immersive-arts/Blimpy/apps/readme.md

# apps

## blender-path

shows how to use blender to create a flightpath and then sending the position and orientation via OSC to a MaxMSP patch to drive a blimp.

Requires the 'blimpy4max' packages to be linked to the packages folder.

## flock_simulation

This Max msp patch is a flocking simulation to auto-control the helium blimps. The simulation sends a position and velocity vector to the manager.

This patch uses an older API and is currently not in working condition.

## ios-remote

iOS app for remote controlling blimps via iPhone or iPad.

## tools

max patches to help.

##XboX-remote

max patch to remote control blimps via xbox - remote controller.
