immersive-arts/Blimpy/robots/wheely/readme.md

# Wheely: Design and Assembly

## 1. Overview
The wheely robot is a ground robot employing mecanum wheels for instantenous movement in any direction.

### Mk02
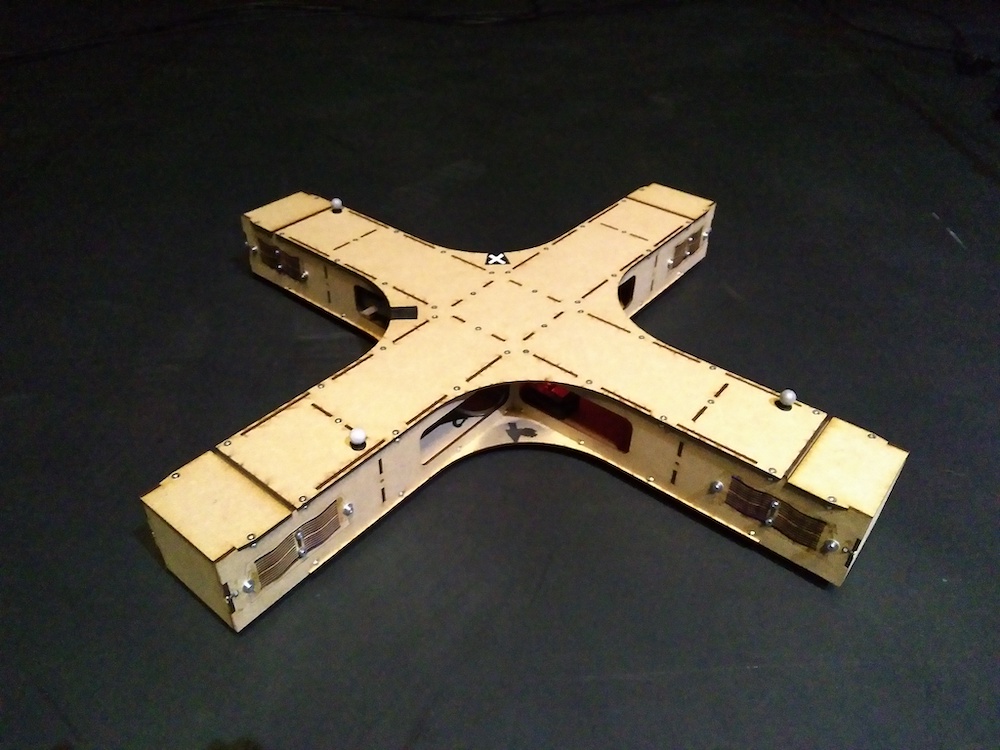
[picture p6: assets/pix/robots/wheely/wheely_mk02.jpg]
 [link](./design/mechanics/mk02/readme.md)

### Mk03
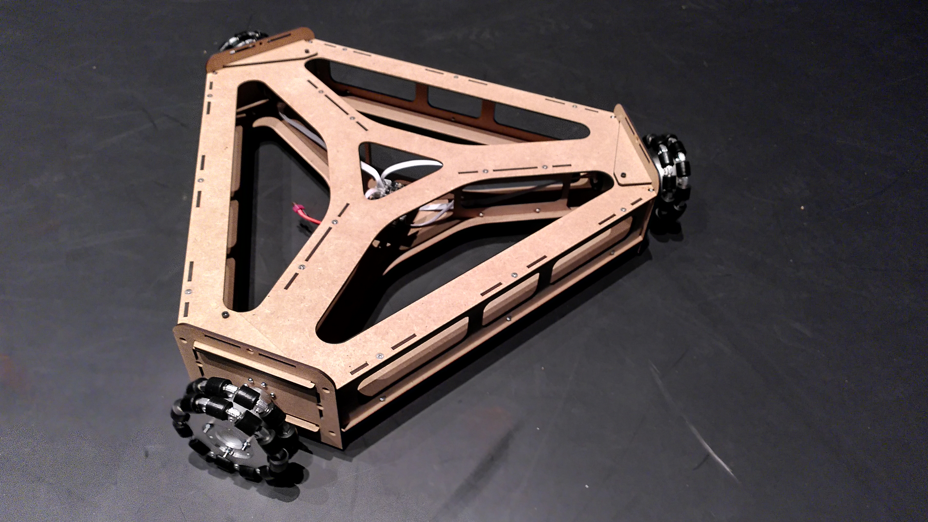
[picture p7: assets/pix/robots/wheely/wheely_mk03.jpg]
 [link](./design/mechanics/mk03.4/readme.md)
