immersive-arts/Blimpy/apps/ios-remote/readme.md

# iOS Remote

The app is able to control one Blimp. The flight model must be functional for this to work properly.

## Usage

Use the two joysticks to steer the blimp. Enable motion sensors for more advanced controls.

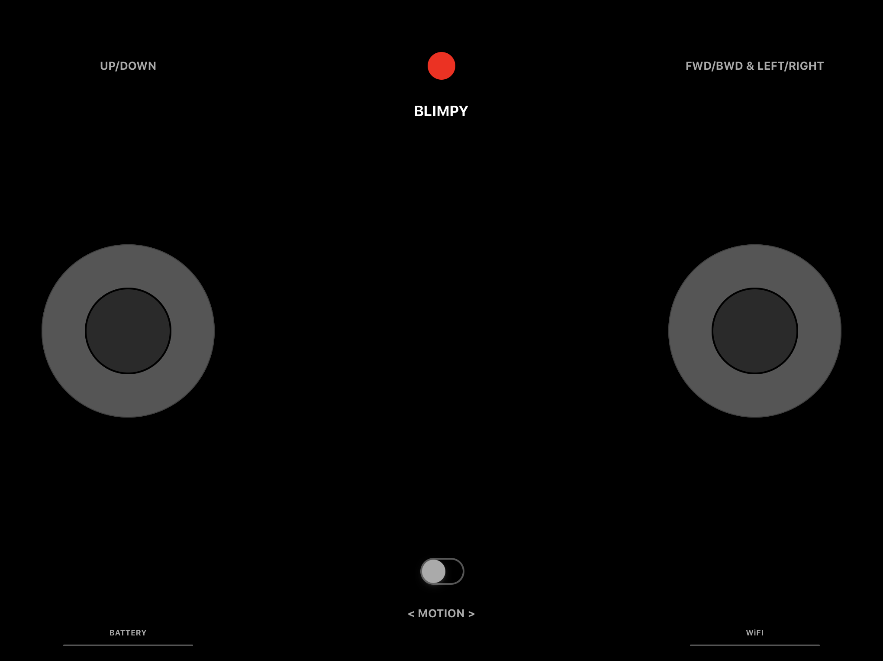
[picture p31: assets/pix/apps/ios-remote/ui.png]


### Configuration

The app can be configured using the "Settings" app on the iPad.

The settings should match the ones used to configure the controller for the blimp that should be controlled with the remote.

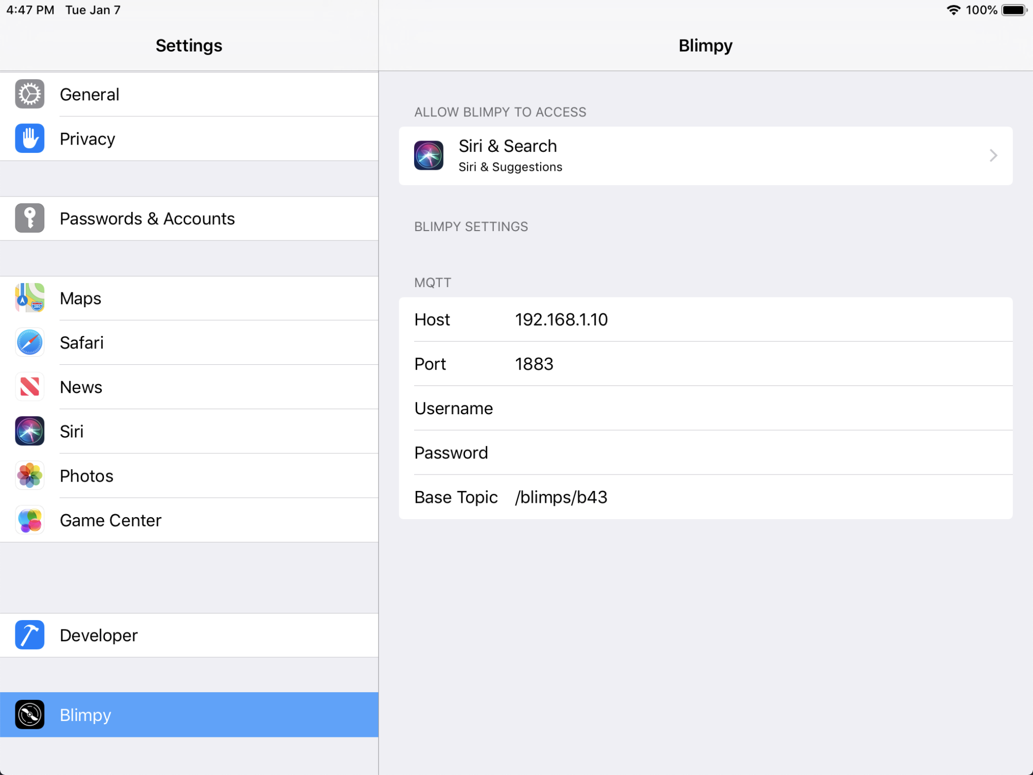
[picture p32: assets/pix/apps/ios-remote/settings.png]


## Installation

To compile and run the app to an iPad you need "Xcode" on your Mac. Before building and running, make sure to set up the project with your own provisioning profile.

### Dependencies

Dependencies are manages using ["CocoaPods"](https://cocoapods.org/app). Download the app and load the project in order to get the dependencies.
