immersive-arts/Blimpy/assets/pix/motorAttachements.pdf

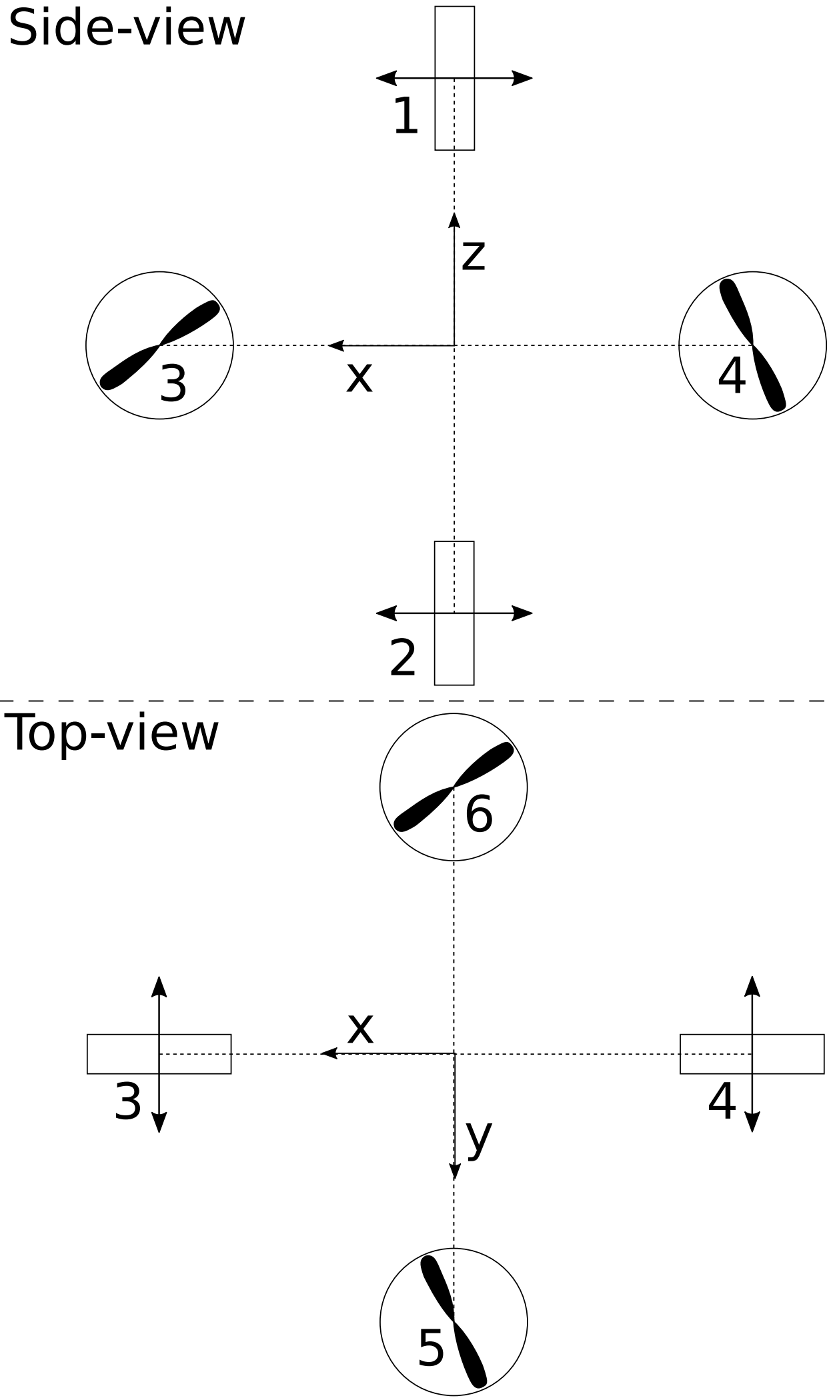
[picture p33: figure]
Side-view; Top-view
