immersive-arts/Blimpy/apps/processing/blimpybirdy/data/bg.jpg

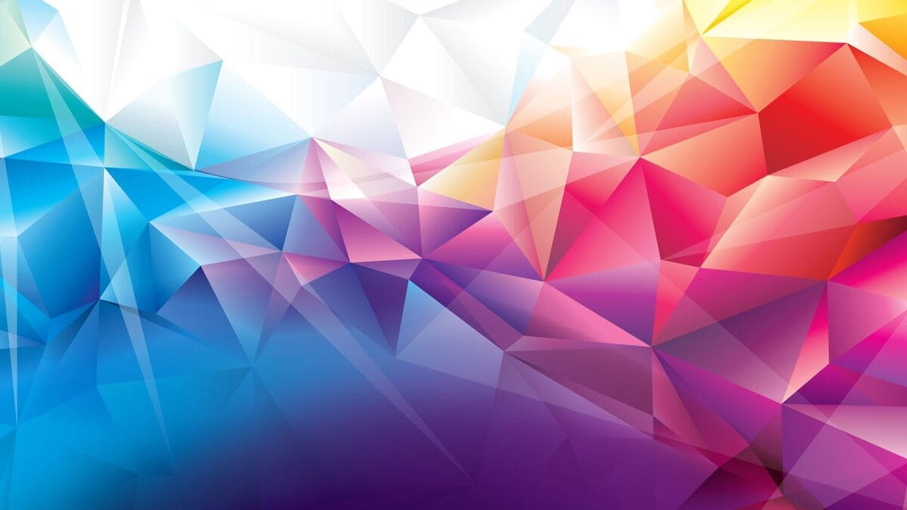
apps/processing/blimpybirdy/data/bg.jpg
