immersive-arts/Blimpy/assets/pix/apps/max/openQueScriptProperties.jpg

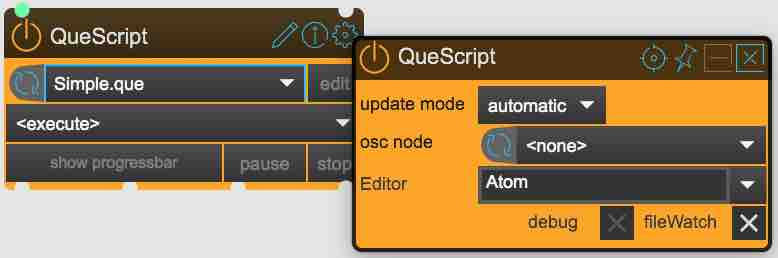
assets/pix/apps/max/openQueScriptProperties.jpg
