immersive-arts/Blimpy/assets/pix/apps/max/QueScript.jpg

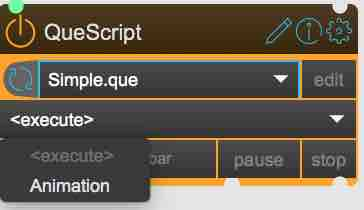
assets/pix/apps/max/QueScript.jpg
