immersive-arts/Blimpy/assets/pix/controller.jpg

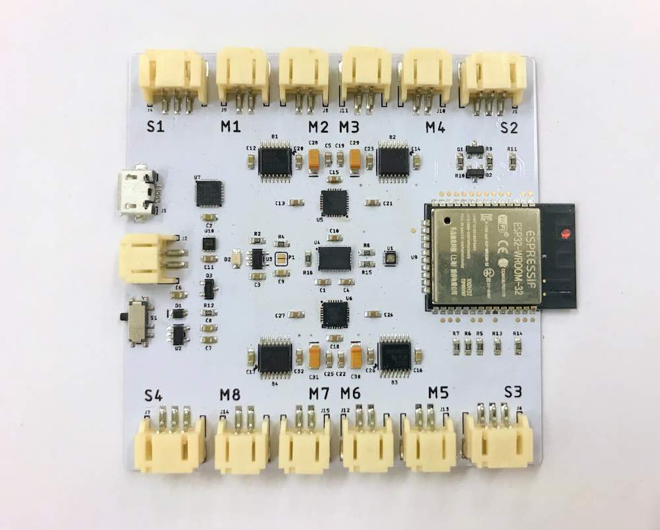
assets/pix/controller.jpg
