immersive-arts/Blimpy/assets/pix/firmware/BT_deviceConfig_Device.jpg

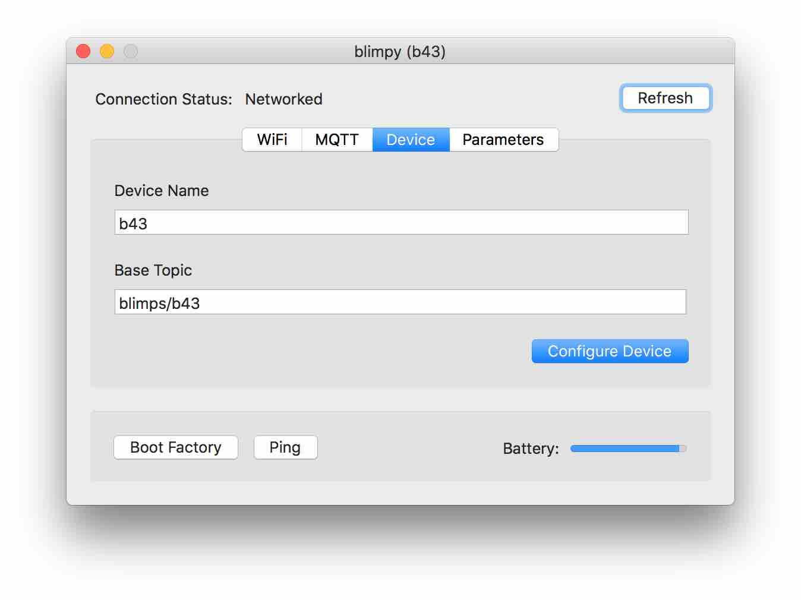
assets/pix/firmware/BT_deviceConfig_Device.jpg
