immersive-arts/Blimpy/assets/pix/firmware/BT_deviceConfig_MQTT.jpg

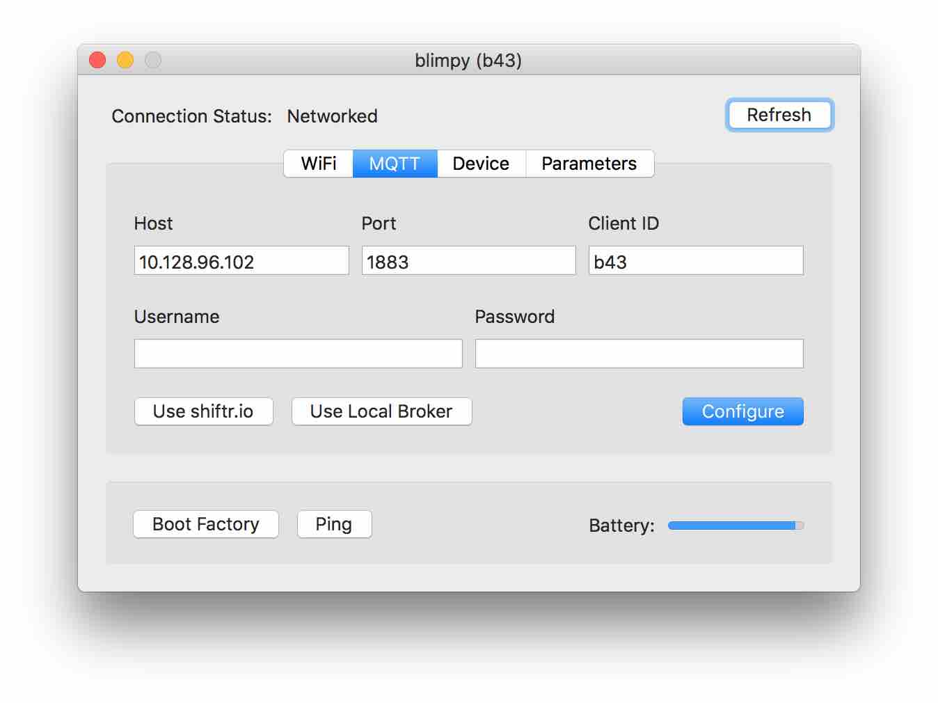
assets/pix/firmware/BT_deviceConfig_MQTT.jpg
