immersive-arts/Blimpy/assets/pix/firmware/BT_deviceConfig_Wifi.jpg

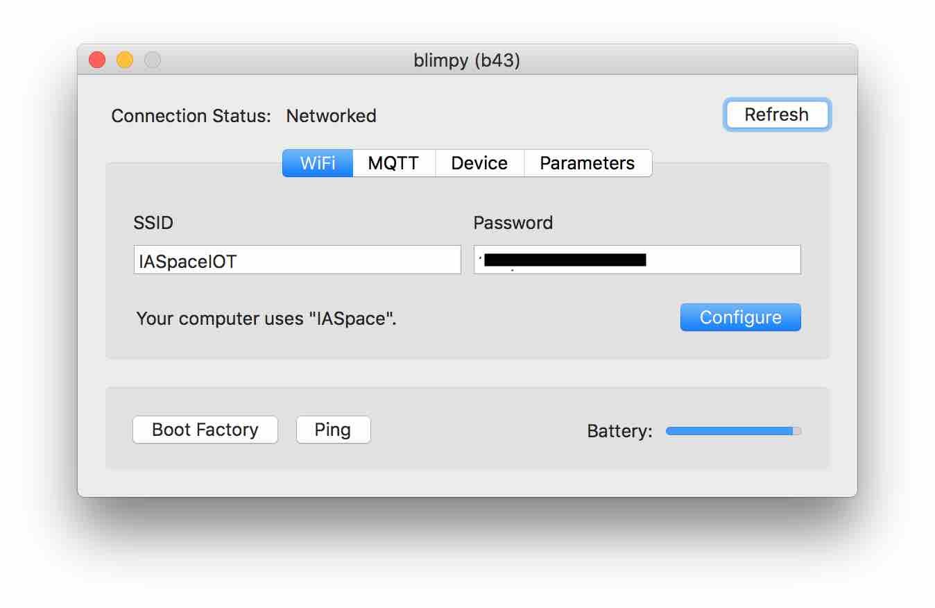
assets/pix/firmware/BT_deviceConfig_Wifi.jpg
