immersive-arts/Blimpy/assets/pix/Motors.jpg

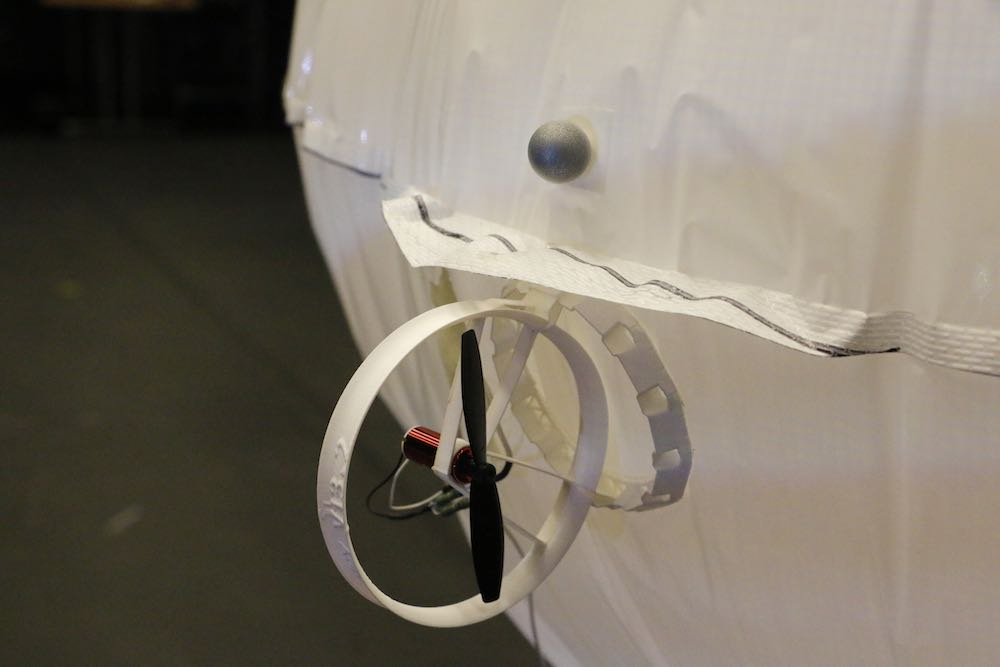
assets/pix/Motors.jpg
