immersive-arts/Blimpy/robots/blimpy/tetra_config.PNG

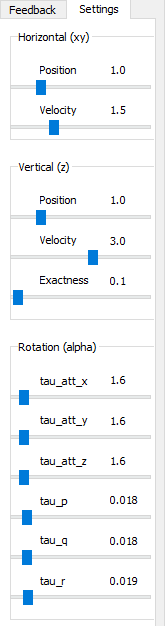
robots/blimpy/tetra_config.PNG
