immersive-arts/Blimpy/robots/blimpy/design/electronics/pcb/PCBWay/PCBWay_BOM.xlsx

Item # | *Designator | *Qty |  | Manufacturer | *Mfg Part # | Description / Value | *Package/Footprint | Type | Your Instructions / Notes | Digikey | Price per Unit | Price Total
1 | J3, J4, J5, J6, J7, J8 | 6 | 60 | JST Sales America Inc. | S2B-PH-SM4-TB | CONN HEADER SMD R/A 2POS 2MM |  | SMD |  | 455-1749-1-ND | 0.56 | 3.36
2 | U3 | 1 | 10 | Microchip | MCP73831T-2ATI/OT | IC CONTROLLR LI-ION 4.2V SOT23-5 | SOT-23-5 | SMD |  | MCP73831T-2ATI/OTCT-ND | 0.54 | 0.54
3 | R3 | 1 | 10 | Ohmite | LVT12R0050FER | RES 0.005 OHM 1% 1W 1206 | 1206 | SMD | Equivalent component permitted | LVT12R0050FERCT-ND | 0.49 | 0.49
4 | R8, R15, R19, R20, R22, R23, R25, R26, R28, R29, R31, R32 | 12 | 120 | Ohmite | KDV12DR100ET | RES 100M OHM 0.5% 1/2W 1206 | 1206 | SMD | Equivalent component permitted | 273-KDV12DR100ETCT-ND | 0.39 | 4.68
5 | C5, C11, C12, C13, C15, C16, C18, C20, C21, C22, C24, C26, C29, C31, C33, C35 | 16 | 160 | Yageo | CC0603KRX7R8BB104 | CAP CER 0.1UF 25V X7R 0603 | 0603 | SMD | Equivalent component permitted | 311-1341-1-ND | 0.1 | 1.6
6 | C7 | 1 | 10 | Yageo | CC0603KRX7R7BB105 | CAP CER 1UF 16V X7R 0603 | 0603 | SMD | Equivalent component permitted | 311-1446-1-ND | 0.11 | 0.11
7 | R1 | 1 | 10 | Yageo | RC0603FR-0710RL | RES SMD 10 OHM 1% 1/10W 0603 | 0603 | SMD | Equivalent component permitted | 311-10.0HRCT-ND | 0.41 | 0.41
8 | R12 | 1 | 10 | Yageo | RC0603FR-07100KL | RES SMD 100K OHM 1% 1/10W 0603 | 0603 | SMD | Equivalent component permitted | 311-100KHRCT-ND | 0.1 | 0.1
9 | R9, R10, R11 | 3 | 30 | Yageo | RC0603FR-0710KL | RES SMD 10K OHM 1% 1/10W 0603 | 0603 | SMD | Equivalent component permitted | 311-10.0KHRCT-ND | 0.1 | 0.3
10 | C2, C3, C6, C8, C9 | 5 | 50 | Murata | GRM188R61A106KE69J | CAP CER 10UF 10V X5R 0603 | 0603 | SMD | Equivalent component permitted | 490-14372-1-ND | 0.17 | 0.85
11 | C14, C19, C25, C28, C30, C34 | 6 | 60 | KEMET | T491A106K010AT | CAP TANT 10UF 10% 10V 1206 | 1206 | SMD | Equivalent component permitted | 399-3684-1-ND | 0.41 | 2.46
12 | D1 | 1 | 10 | STMicroelectronics | BAT20JFILM | DIODE SCHOTTKY 23V 1A SOD323 | SOD-323 | SMD |  | 497-3381-1-ND | 0.31 | 0.31
13 | R17 | 1 | 10 | Yageo | RC0603FR-071ML | RES SMD 1M OHM 1% 1/10W 0603 | 0603 | SMD | Equivalent component permitted | 311-1.00MHRCT-ND | 0.1 | 0.1
14 | R2, R5, R6, R7, R35, R36, R37 | 7 | 70 | Yageo | RC0603JR-071KL | RES SMD 1K OHM 5% 1/10W 0603 | 0603 | SMD | Equivalent component permitted | 311-1.0KGRCT-ND | 0.1 | 0.7
15 | R4 | 1 | 10 | Yageo | RC0603FR-072KL | RES SMD 2K OHM 1% 1/10W 0603 | 0603 | SMD | Equivalent component permitted | 311-2.00KHRCT-ND | 0.1 | 0.1
16 | C4, C10, C17, C23, C27, C32, C36 | 7 | 70 | Murata | GRM188R61E225KA12D | CAP CER 2.2UF 25V X5R 0603 | 0603 | SMD | Equivalent component permitted | 490-10731-1-ND | 0.18 | 1.26
17 | J9, J10, J11, J12, J13, J14, J15 | 7 | 70 | JST Sales America Inc. | S3B-PH-SM4-TB | CONN HEADER SMD R/A 3POS 2MM |  | SMD |  | 455-1750-1-ND | 0.67 | 4.69
18 | D4, D5, D6 | 3 | 30 | Osram | LG R971-KN-1 | LED GREEN DIFFUSED 0805 SMD | 0805 | SMD |  | 475-1410-1-ND | 0.25 | 0.75
19 | R13, R14, R18, R38 | 4 | 40 | Yageo | RC0603JR-074K7L | RES SMD 4.7K OHM 5% 1/10W 0603 | 0603 | SMD | Equivalent component permitted | 311-4.7KGRCT-ND | 0.1 | 0.4
20 | C1 | 1 | 10 | Yageo | CC0603KRX7R7BB474 | CAP CER 0.47UF 16V X7R 0603 | 0603 | SMD | Equivalent component permitted | 311-1428-1-ND | 0.2 | 0.2
21 | R16, R21, R24, R27, R30, R33 | 6 | 60 | Yageo | RC0603FR-0747KL | RES SMD 47K OHM 1% 1/10W 0603 | 0603 | SMD | Equivalent component permitted | 311-47.0KHRCT-ND | 0.1 | 0.6
22 | Q4 | 1 | 10 | Vishay Siliconix | SQ4431EY-T1_GE3 | MOSFET P-CH 30V 10.8A 8SOIC | 8-SOIC | SMD |  | SQ4431EY-T1_GE3CT-ND | 0.86 | 0.86
23 | Q1, Q2, Q5 | 3 | 30 | Diodes Incorporated | MMBT2222A-7-F | TRANS NPN 40V 0.6A SMD SOT23-3 | SOT-23-3 | SMD |  | MMBT2222A-FDICT-ND | 0.13 | 0.39
24 | U2 | 1 | 10 | Diodes Incorporated | AP2112K-3.3TRG1 | LDO Voltage Regulators 600mA CMOS LDO 50mA 3.3V 250mV | SOT-25-5 | SMD |  | AP2112K-3.3TRG1DICT-ND | 0.45 | 0.45
25 | D3 | 1 | 10 | Diodes Incorporated | BAS70-05WFILM | DIODE ARRAY SCHOTTKY 70V SOT323 | SOT-323 | SMD |  | 497-15794-1-ND | 0.42 | 0.42
26 | R34 | 1 | 10 | Eaton | CB61F10A-TR1 | FUSE BRD MNT 10A 125VAC/VDC SMD |  | SMD |  | 283-4102-1-ND | 1.12 | 1.12
27 | U7 | 1 | 10 | Silicon Labs | CP2104-F03-GMR | IC SGL USB-TO-UART BRIDGE 24QFN |  | SMD |  | 336-4146-1-ND | 1.6 | 1.6
28 | Q3 | 1 | 10 | Diodes Incorporated | DMP2035U-7 | MOSFET P-CH 20V 3.6A SOT-23 |  | SMD |  | DMP2035U-7DICT-ND | 0.4 | 0.4
29 | M0, M1, M2, M3, M4, M5 | 6 | 60 | Texas Instruments | DRV8833PWPR | IC MOTOR DRIVER PAR 16HTSSOP | 16-HTSSOP | SMD |  | 296-29434-1-ND | 2.01 | 12.06
30 | U9 | 1 | 10 | Espressif Systems | ESP32-WROOM-32 | RX TXRX MOD WIFI SURFACE MOUNT |  | SMD |  | 1904-1010-1-ND | 3.69 | 3.69
31 | S1 | 1 | 10 | Panasonic | EVQ-PUJ02K | SWITCH TACTILE SPST-NO 0.05A 12V |  | SMD |  | P10851SCT-ND | 0.57 | 0.57
32 | U4 | 1 | 10 | Maxim Integrated | MAX17201G+ | IC BATTERY MONITOR 14TDFN | 14-WFDFN Exposed Pad | SMD |  | MAX17201G+-ND | 3.29 | 3.29
33 | J1 | 1 | 10 | Hirose | ZX62-B-5PA(33) | CONN RCPT USB2.0 MICRO B SMD R/A |  | SMD |  | H125270CT-ND | 0.81 | 0.81
34 | D2 | 1 | 10 | Osram | LO R976-PS-1 | LED ORANGE DIFFUSED 0805 SMD | 0805 | SMD |  | 475-2488-1-ND | 0.27 | 0.27
35 | U1 | 1 | 10 | Cree | CLMVC-FKA-CL1D1L71BB7C3C3 | LED RGB CLEAR 4PLCC SMD | 4-PLCC | SMD |  | CLMVC-FKA-CL1D1L71BB7C3C3CT-ND | 0.18 | 0.18
36 | U5 | 1 | 10 | Semtech Corporation | SX1509BIULTRT | IC GPIO EXPANDER I2C 16CH 28QFN |  | SMD |  | SX1509BIULCT-ND | 3.44 | 3.44
 |  |  |  |  |  |  |  |  |  |  | 24.73 | 53.56
 |  | 113
