immersive-arts/Blimpy/(list of files, cad)

Other CAD files:
apps/blender-path/Show.blend
apps/blender-path/Simple.blend
assets/pix/robots/blimpy/fanSetup.blend
robots/blimpy/design/inflationSim.blend
robots/wheely/design/mechanics/mk02/wheely_mk2.blend
robots/wheely/design/mechanics/mk03.4/wheely_mk3.4.blend
