immersive-arts/Blimpy/robots/wheely/firmware/nuttx/nuttx/Documentation/guides/tasktrace.rst

==========
Task Trace
==========

Task Trace is the tool to collect the various events in the NuttX kernel and display the result graphically.

It can collect the following events.

  - Task execution, termination, switching
  - System call enter/leave
  - Interrupt handler enter/leave

.. toctree::
  :maxdepth: 1
  :caption: Contents:

  tasktraceuser.rst
  tasktraceinternal.rst

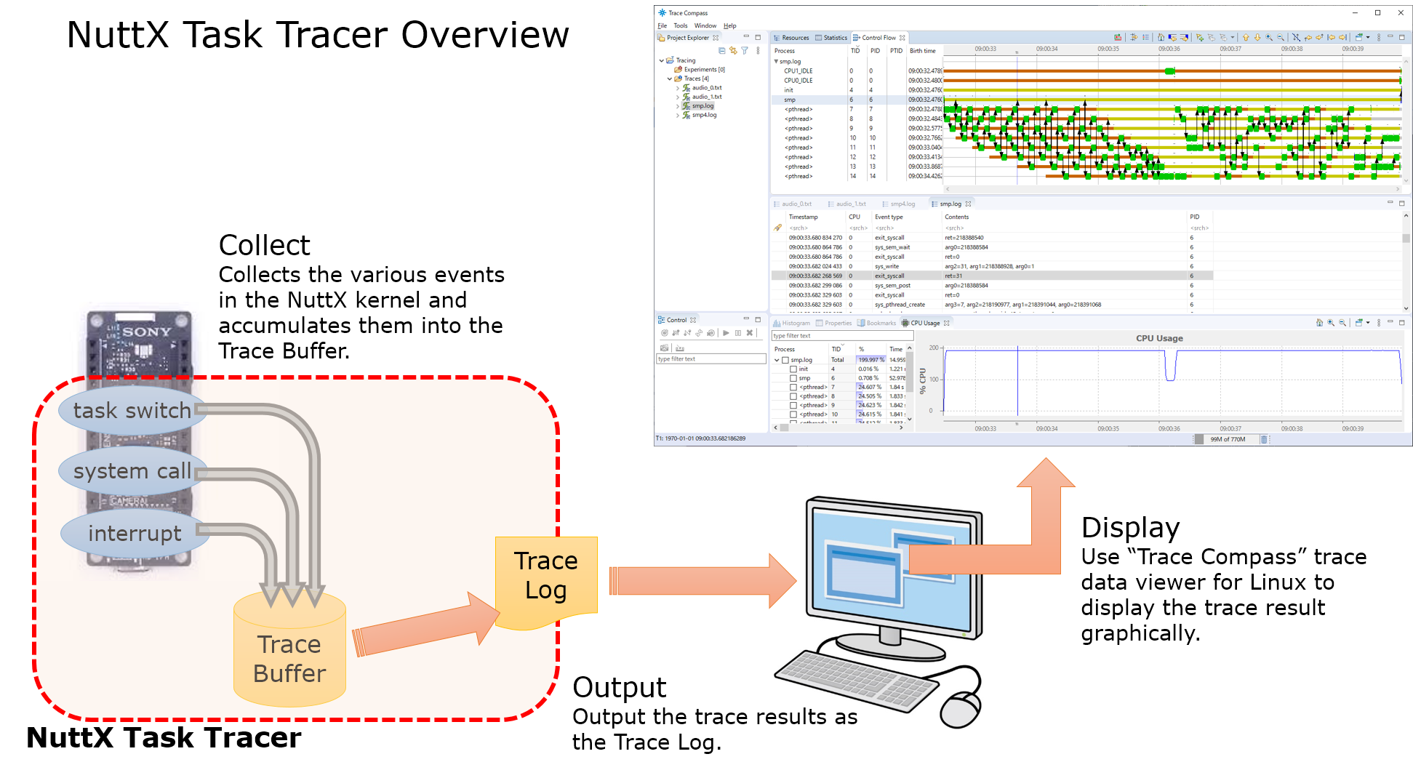
[picture p88: robots/wheely/firmware/nuttx/nuttx/Documentation/guides/image/task-trace-overview.png]
