immersive-arts/Blimpy/robots/blimpy/design/electronics/pcb/blimpy-2.1_fix.pdf

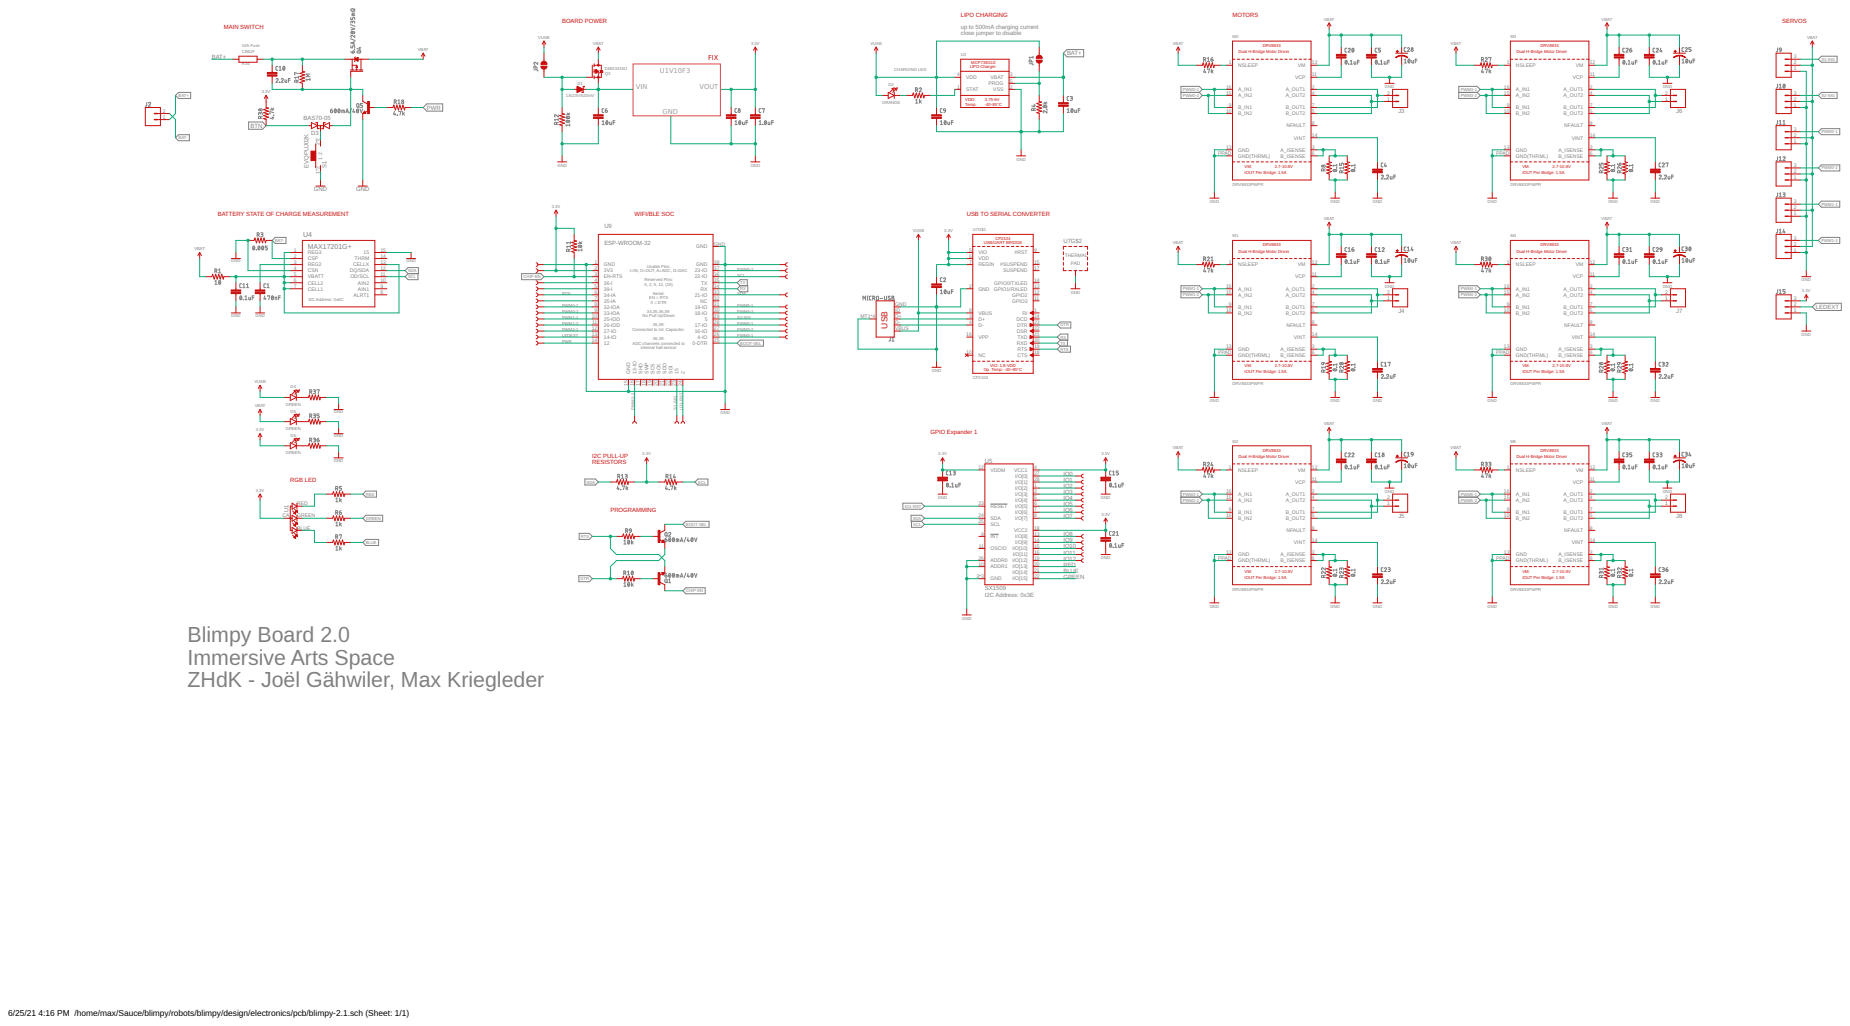
[picture p110: page 1]

LIPO CHARGING
up to 500mA charging current
close jumper to disable

Dual H-Bridge Motor Driver

BATTERY STATE OF CHARGE MEASUREMENT

USB TO SERIAL CONVERTER

I=IN, O=OUT, A=ADC, D=DAC

No Pull Up/Down

Connected to Int. Capacitor.

ADC channels connected to
internal hall sensor

Blimpy Board 2.0
Immersive Arts Space
ZHdK - Joël Gähwiler, Max Kriegleder

6/25/21 4:16 PM /home/max/Sauce/blimpy/robots/blimpy/design/electronics/pcb/blimpy-2.1.sch (Sheet: 1/1)
