immersive-arts/Blimpy/robots/blimpy/design/electronics/pcb/blimpy-2.1.pdf

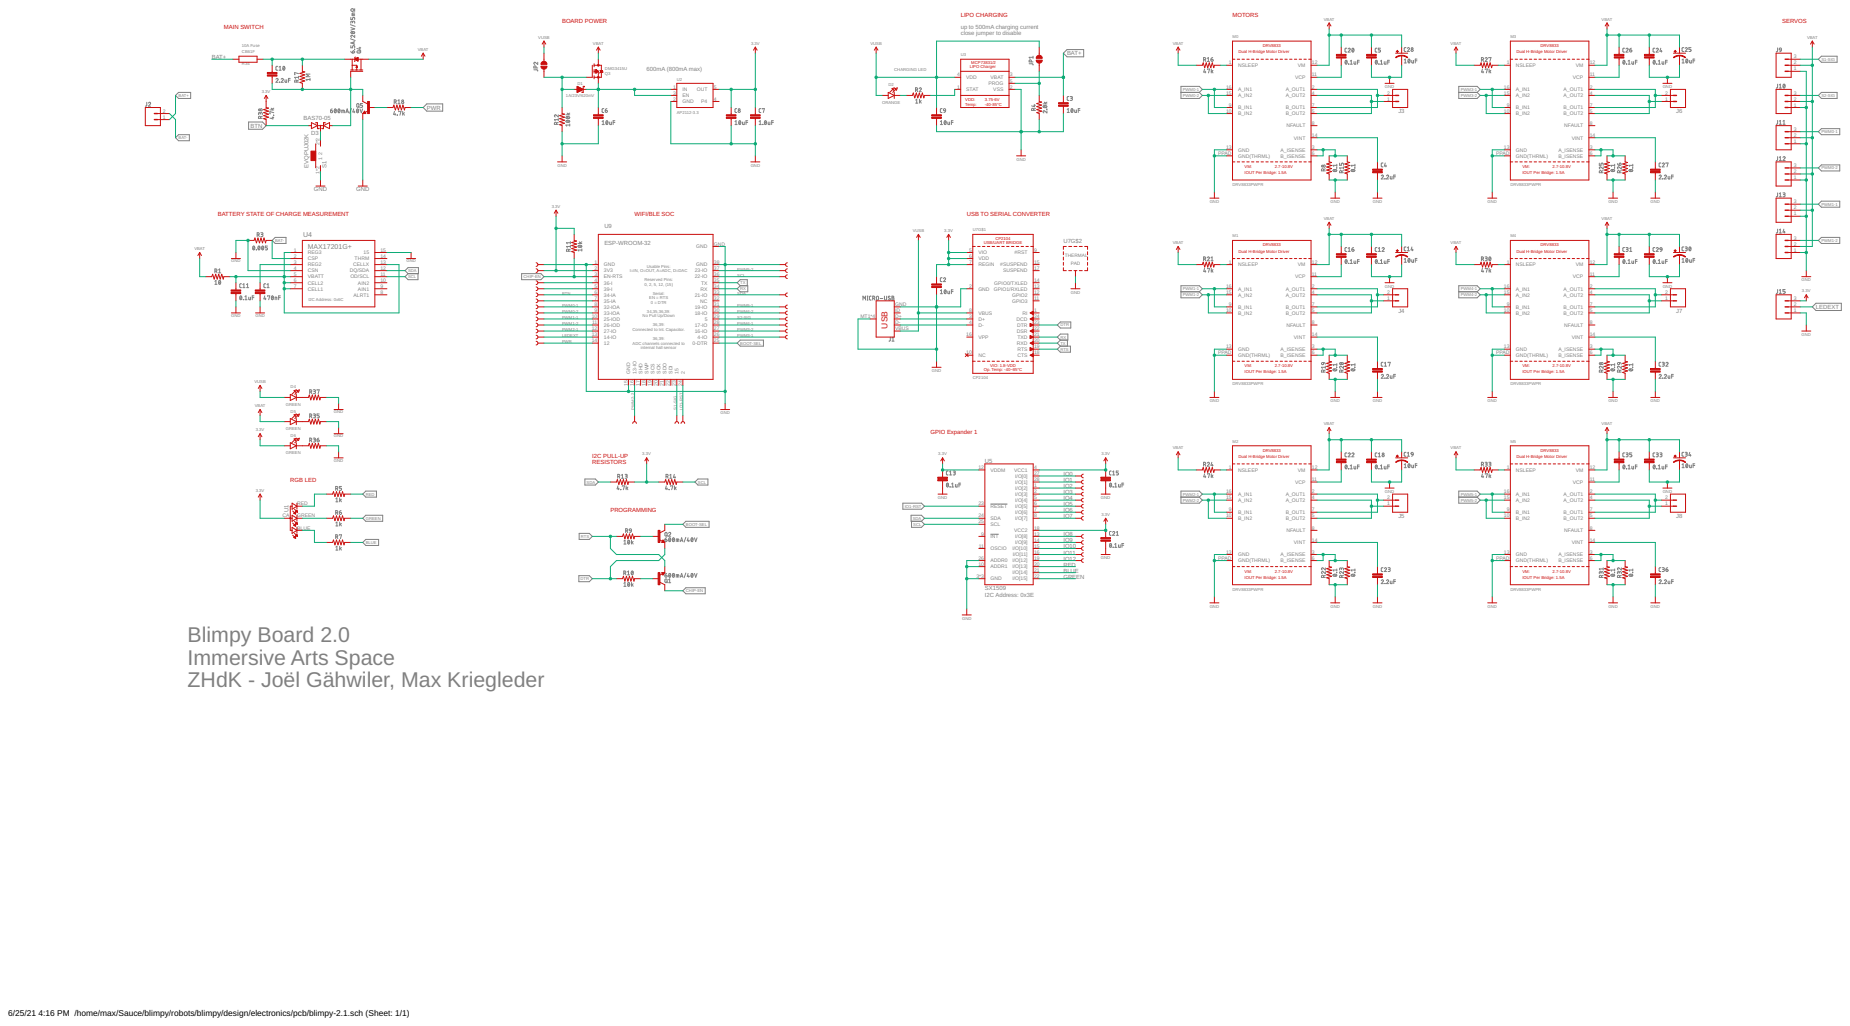
[picture p111: page 1]

LIPO CHARGING
up to 500mA charging current close jumper to disable

DRV8833 Dual H-Bridge Motor Driver

BATTERY STATE OF CHARGE MEASUREMENT

USB TO SERIAL CONVERTER

I=IN, O=OUT, A=ADC, D=DAC

Reserved Pins: 0, 2, 5, 12, (15) Serial: EN = RTS

34,35,36,39: No Pull Up/Down

VIO: 1.8-VDD Op. Temp: -40~85°C U

36,39: Connected to Int. Capacitor. 36,39: ADC channels connected to

Blimpy Board 2.0
Immersive Arts Space
ZHdK - Joël Gähwiler, Max Kriegleder

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
