immersive-arts/Blimpy/robots/blimpy/design/electronics/pcb/blimpy-2.0.pdf

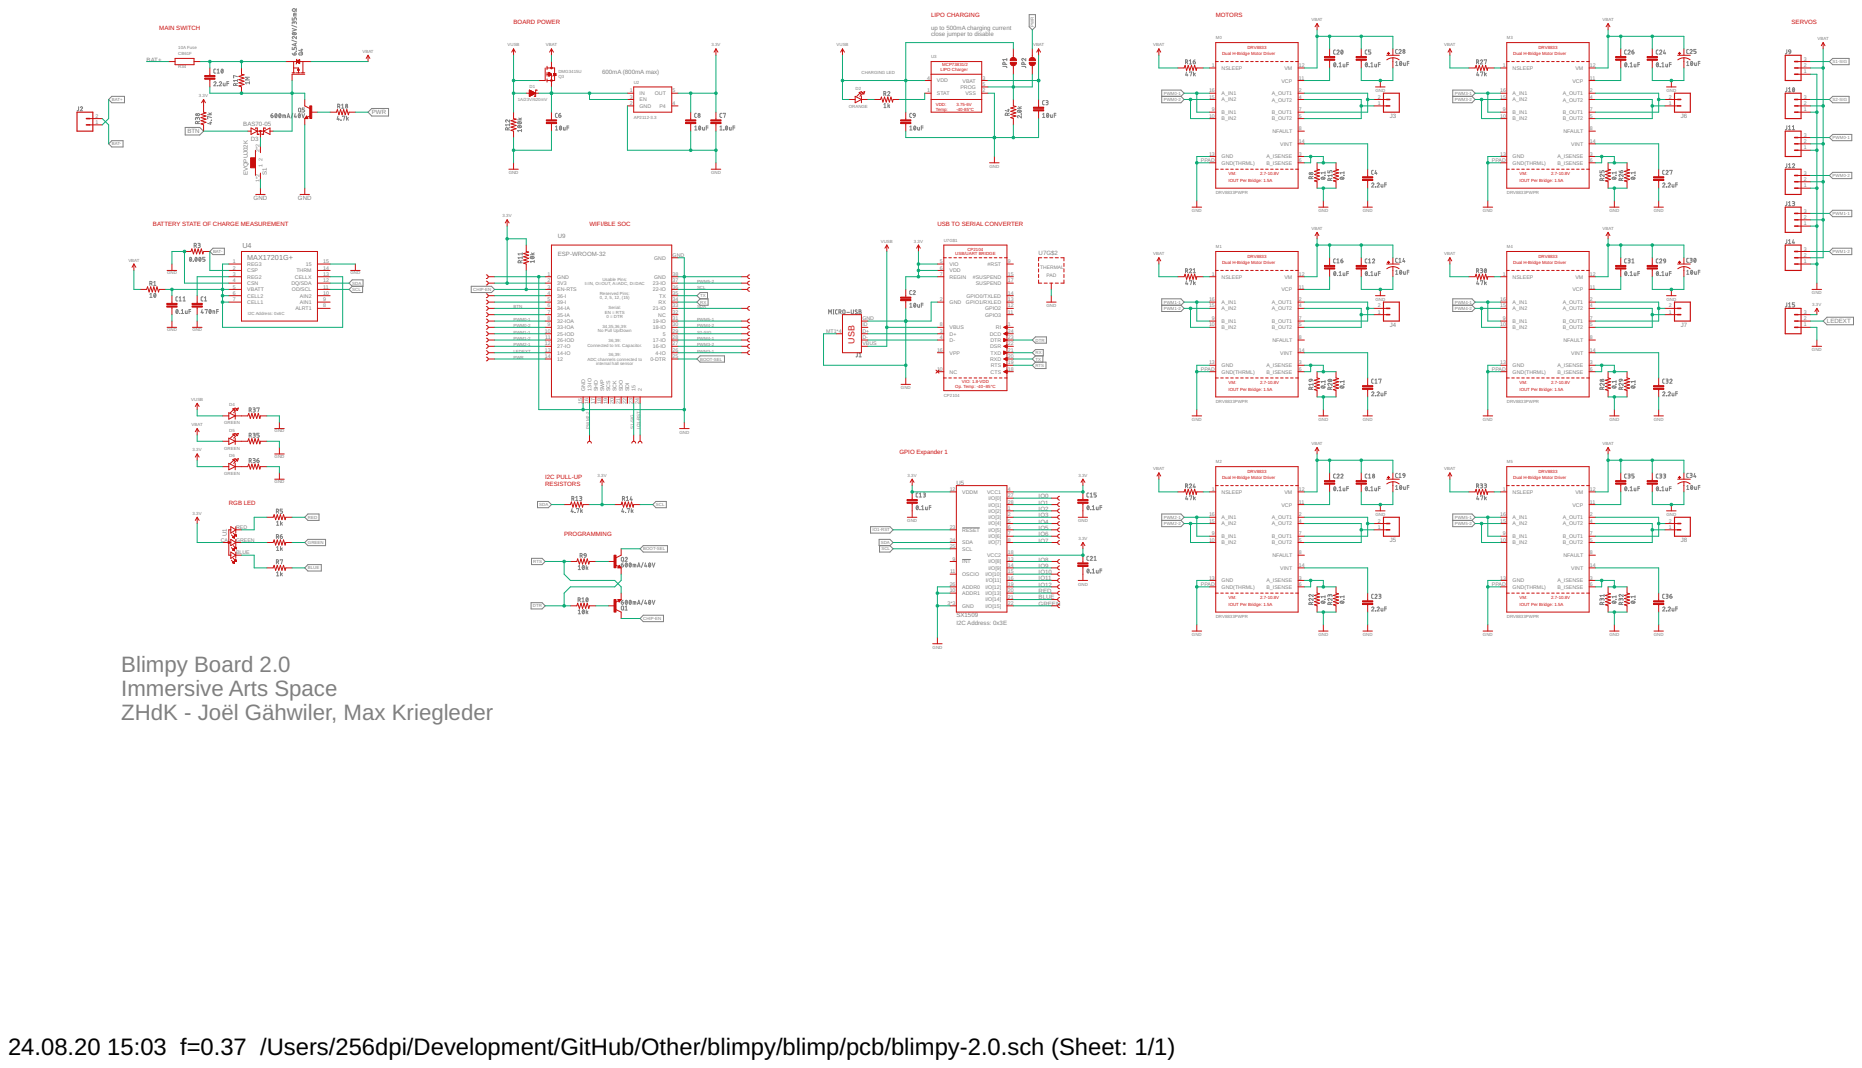
[picture p112: page 1]

LIPO CHARGING
up to 500mA charging current close jumper to disable

DRV8833 Dual H-Bridge Motor Driver

BATTERY STATE OF CHARGE MEASUREMENT

USB TO SERIAL CONVERTER

I=IN, O=OUT, A=ADC, D=DAC

Reserved Pins: 0, 2, 5, 12, (15) Serial: EN = RTS

34,35,36,39: No Pull Up/Down

VIO: 1.8-VDD Op. Temp: -40~85°C USB

36,39: Connected to Int. Capacitor. 36,39: ADC channels connected to

Blimpy Board 2.0
Immersive Arts Space
ZHdK - Joël Gähwiler, Max Kriegleder

24.08.20 15:03 f=0.37 /Users/256dpi/Development/GitHub/Other/blimpy/blimp/pcb/blimpy-2.0.sch (Sheet: 1/1)
