immersive-arts/Blimpy/robots/blimpy/design/electronics/pcb/blimpy-1.0-B-board.pdf

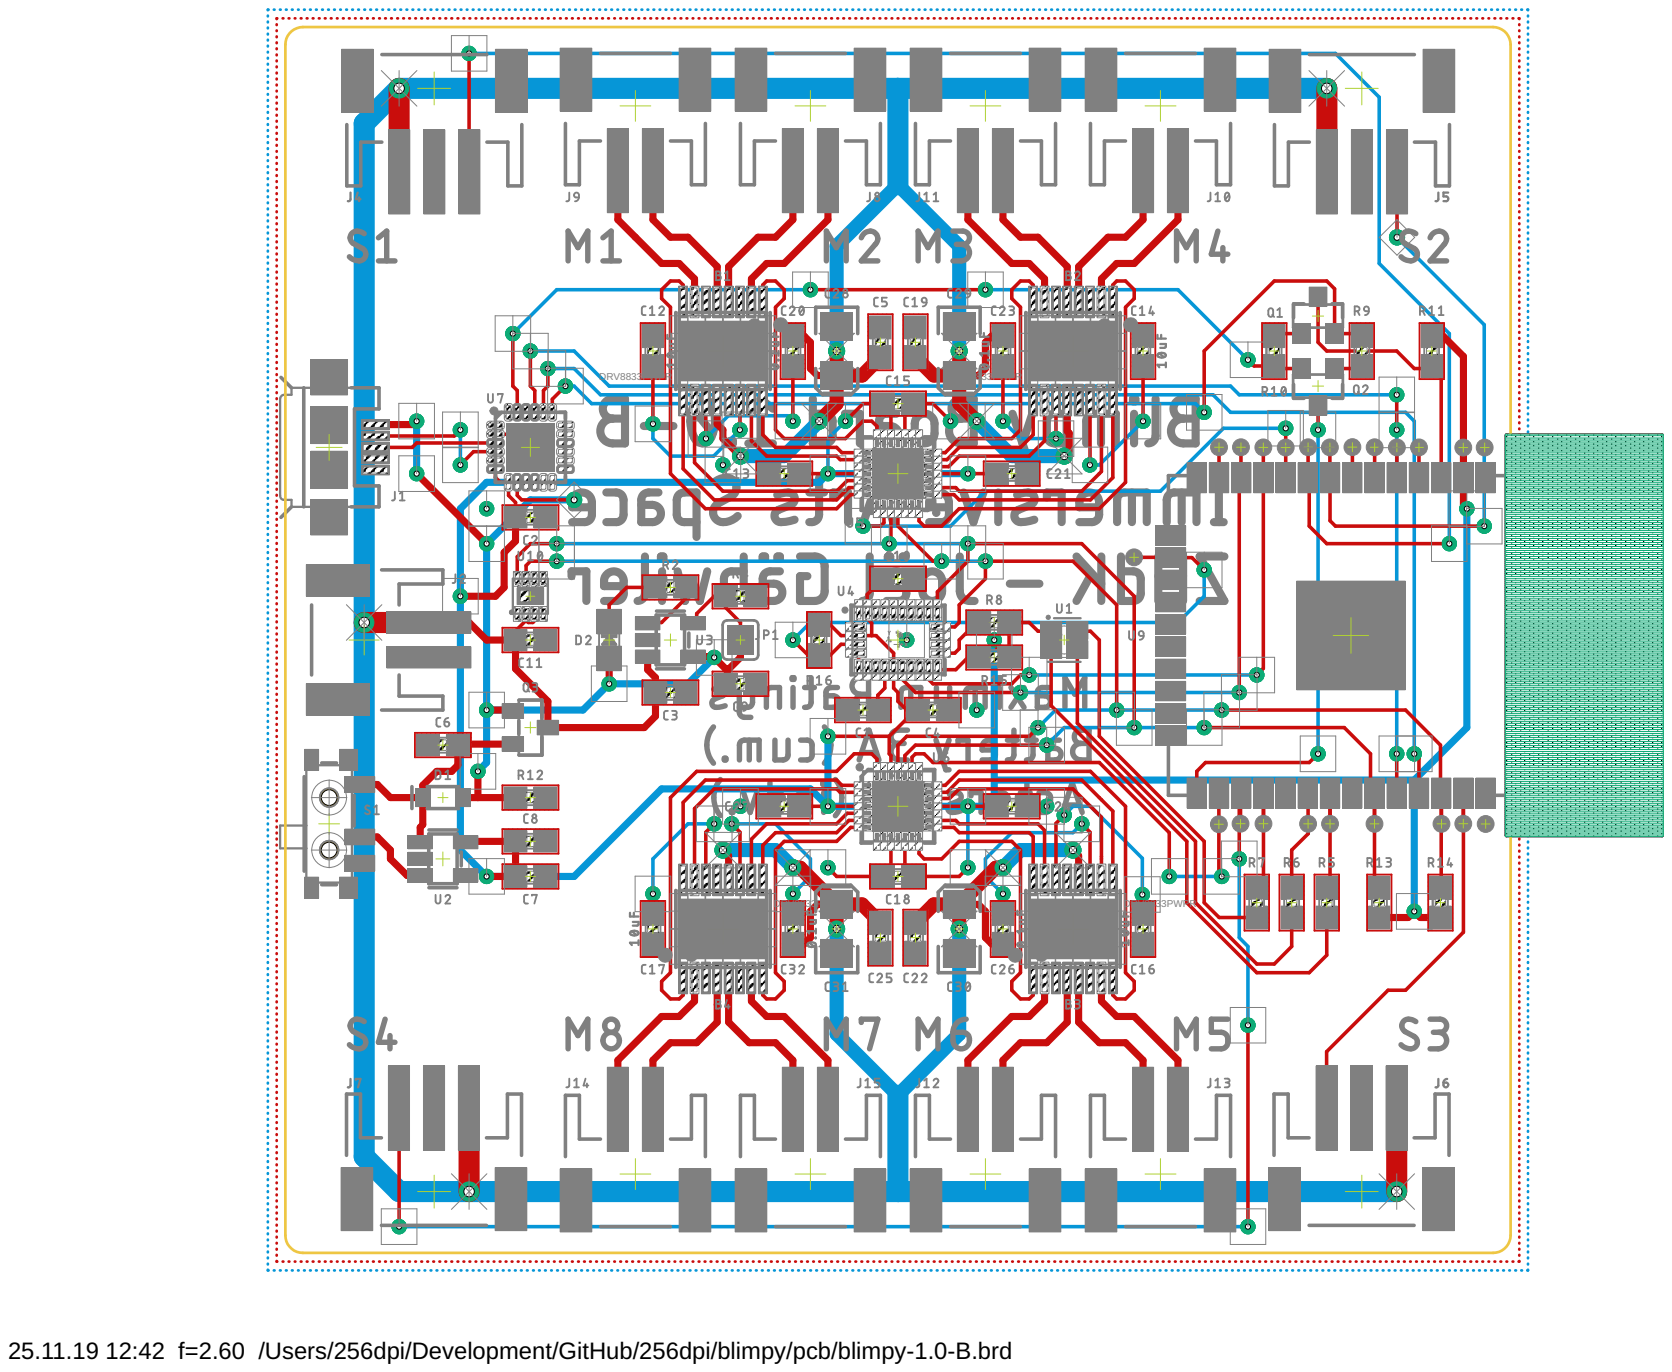
[picture p113: page 1]

25.11.19 12:42 f=2.60 /Users/256dpi/Development/GitHub/256dpi/blimpy/pcb/blimpy-1.0-B.brd
