immersive-arts/Blimpy/robots/blimpy/design/electronics/pcb/blimpy-1.0-B-schema.pdf

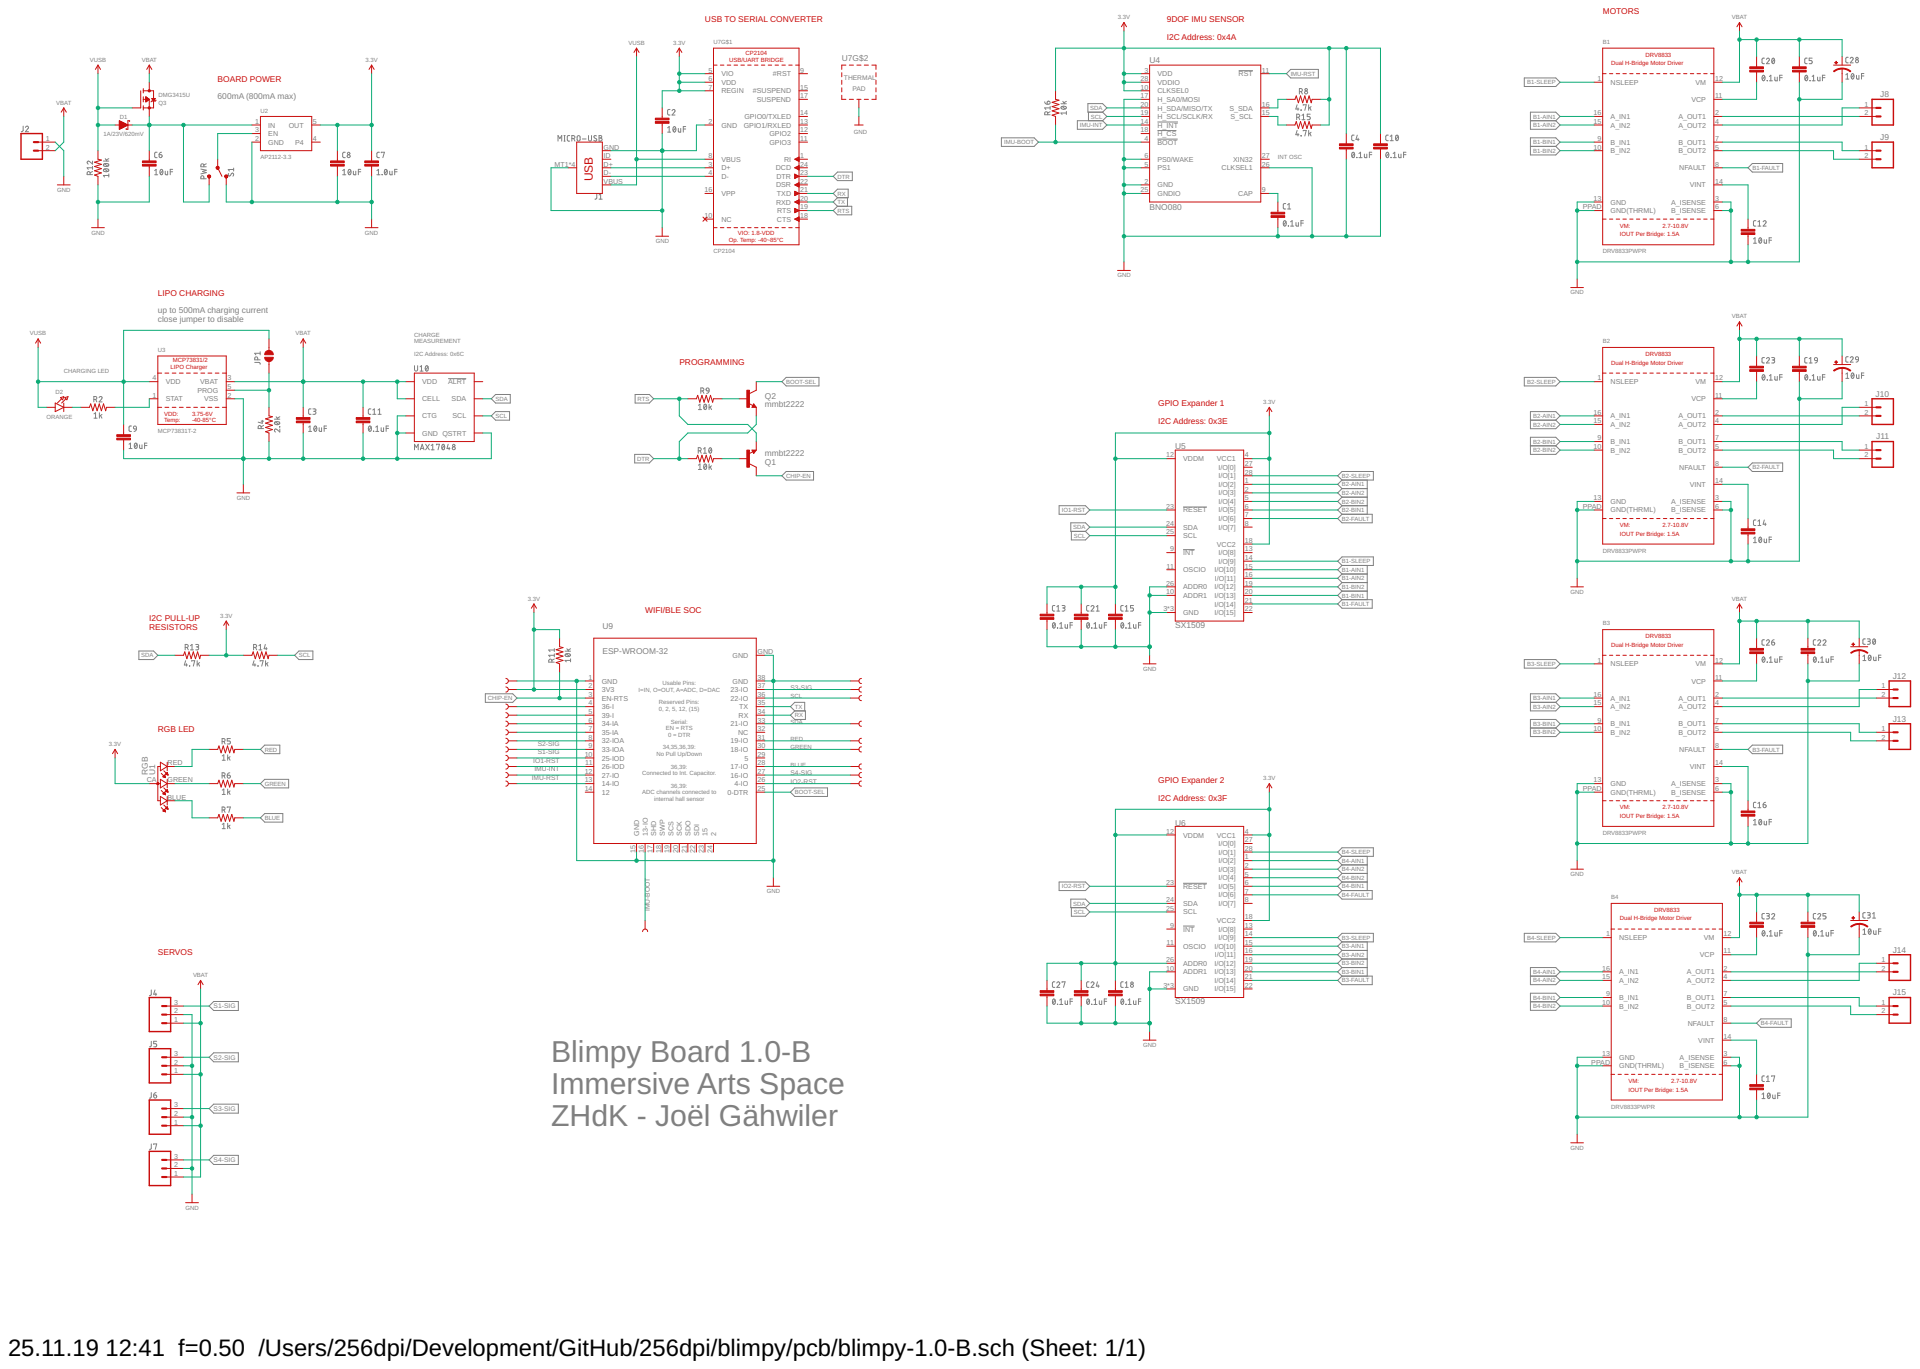
[picture p114: page 1]

USB TO SERIAL CONVERTER

DRV8833 Dual H-Bridge Motor Driver

VIO: 1.8-VDD Op. Temp: -40~85°C USB

LIPO CHARGING
up to 500mA charging current close jumper to disable

GND QSTRT SCL SDA

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

0 = DTR
34,35,36,39: No Pull Up/Down

36,39: Connected to Int. Capacitor. 36,39: ADC channels connected to

25.11.19 12:41 f=0.50 /Users/256dpi/Development/GitHub/256dpi/blimpy/pcb/blimpy-1.0-B.sch (Sheet: 1/1)
