immersive-arts/Blimpy/robots/wheely/firmware/nuttx/apps/graphics/twm4nx/Twm4NX-Threading.pdf

### Twm4x Main Thread

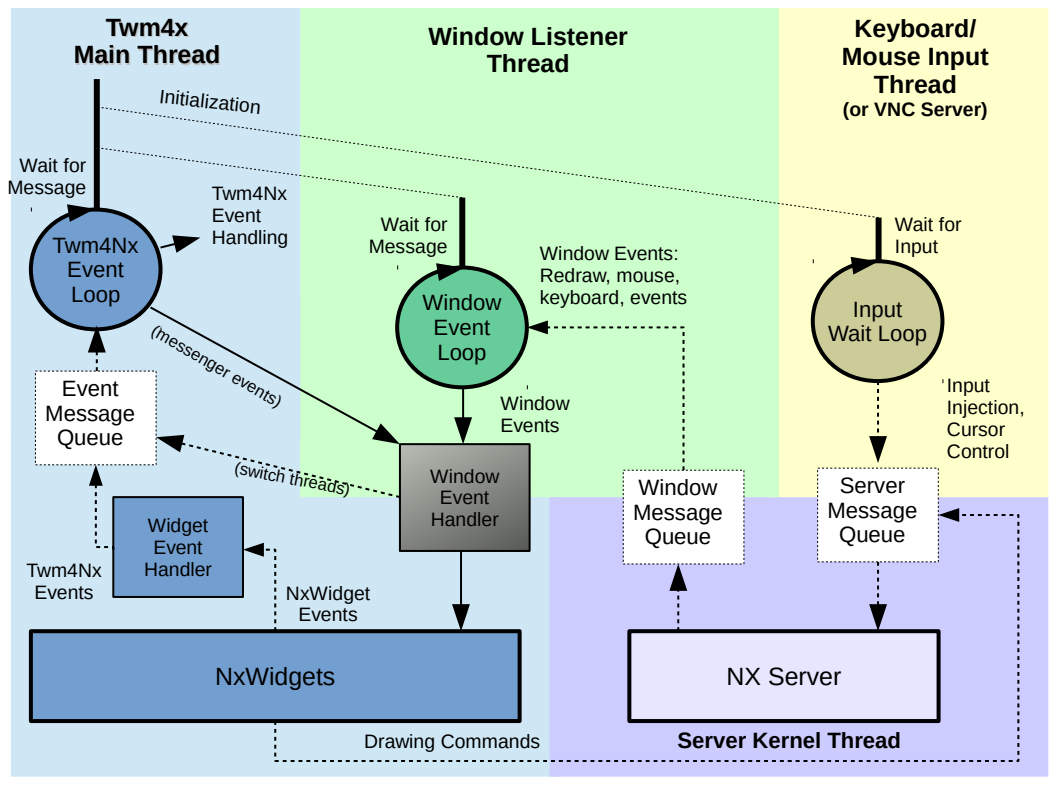
[picture p115: page 1]
Widget Event Handler; Twm4Nx Event Loop; Twm4Nx Event Handling; Initialization; Window Event Loop; Window Listener Thread; Input Wait Loop; Server Message Queue; Window Message Queue; Event Message Queue; NxWidgets; NX Server; Input Injection, Cursor Control; Window Events: Redraw, mouse, keyboard, events; Window Events; Drawing Commands; (switch threads); (messenger events); NxWidget Events; Twm4Nx Events; Window Event Handler; Wait for Input; Wait for Message

Keyboard/
Mouse Input
Thread
(or VNC Server)

Server Kernel Thread
