immersive-arts/Blimpy/robots/blimpy/design/electronics/pcb/blimpy-2.1.brd

## EAGLE design robots/blimpy/design/electronics/pcb/blimpy-2.1.brd (2020-08-26)

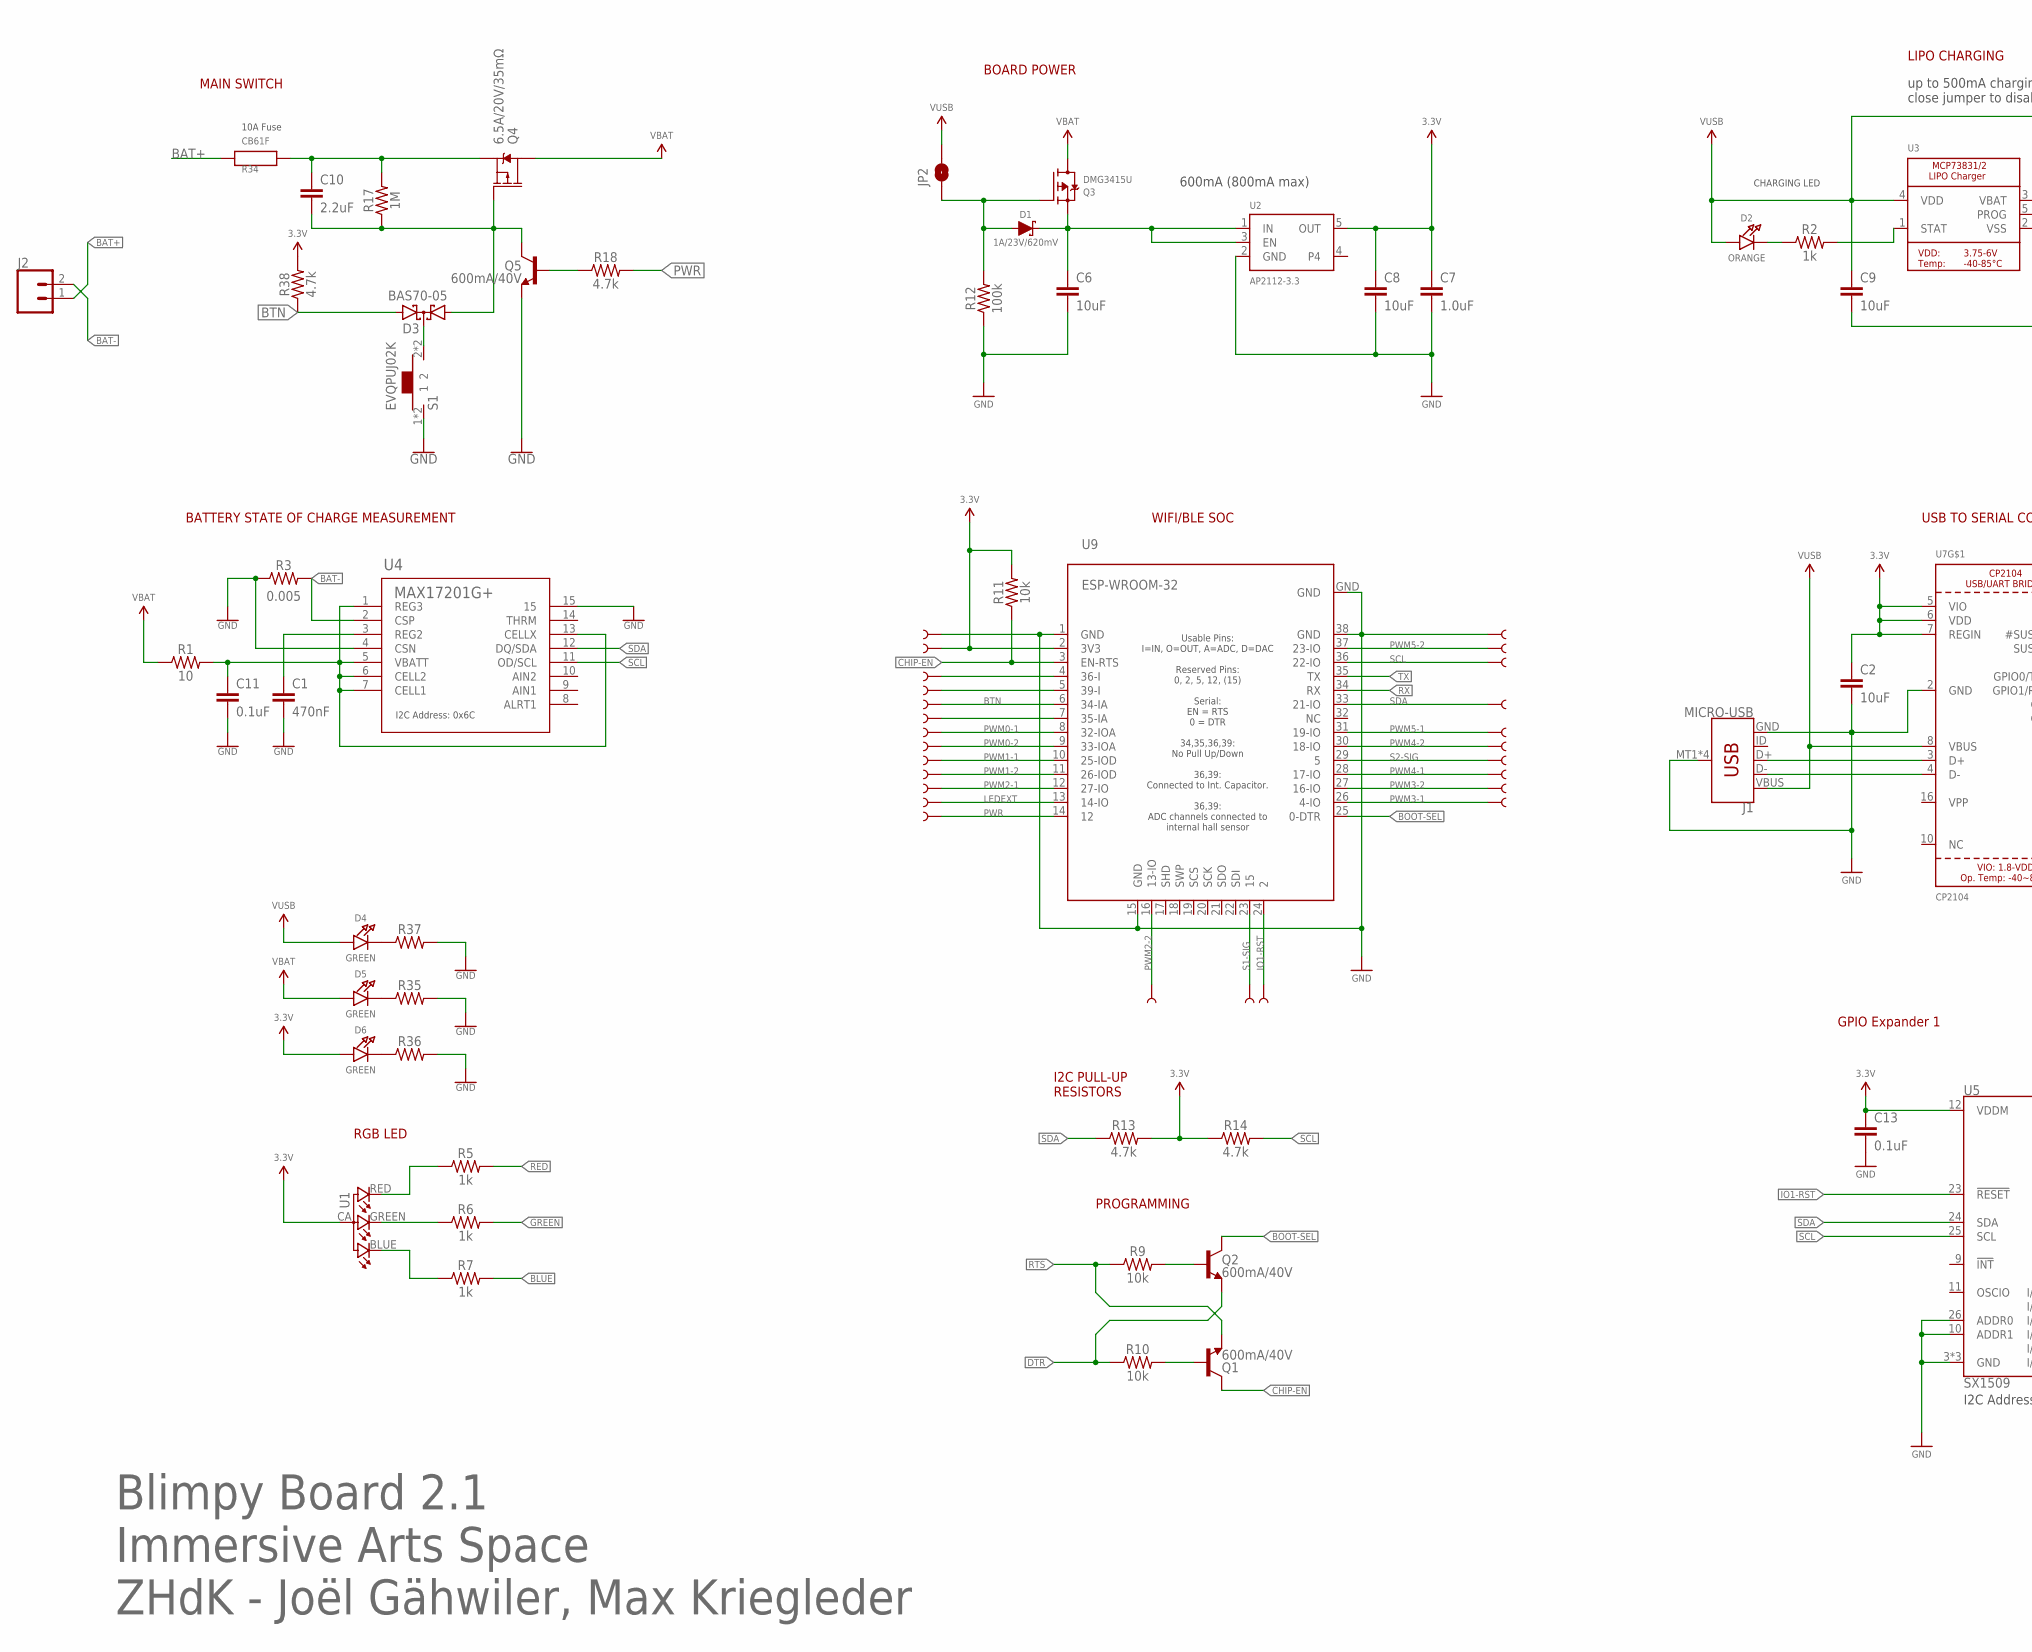
[picture p116: schematic blimpy-2.1.sch, part in row 1, column 1]

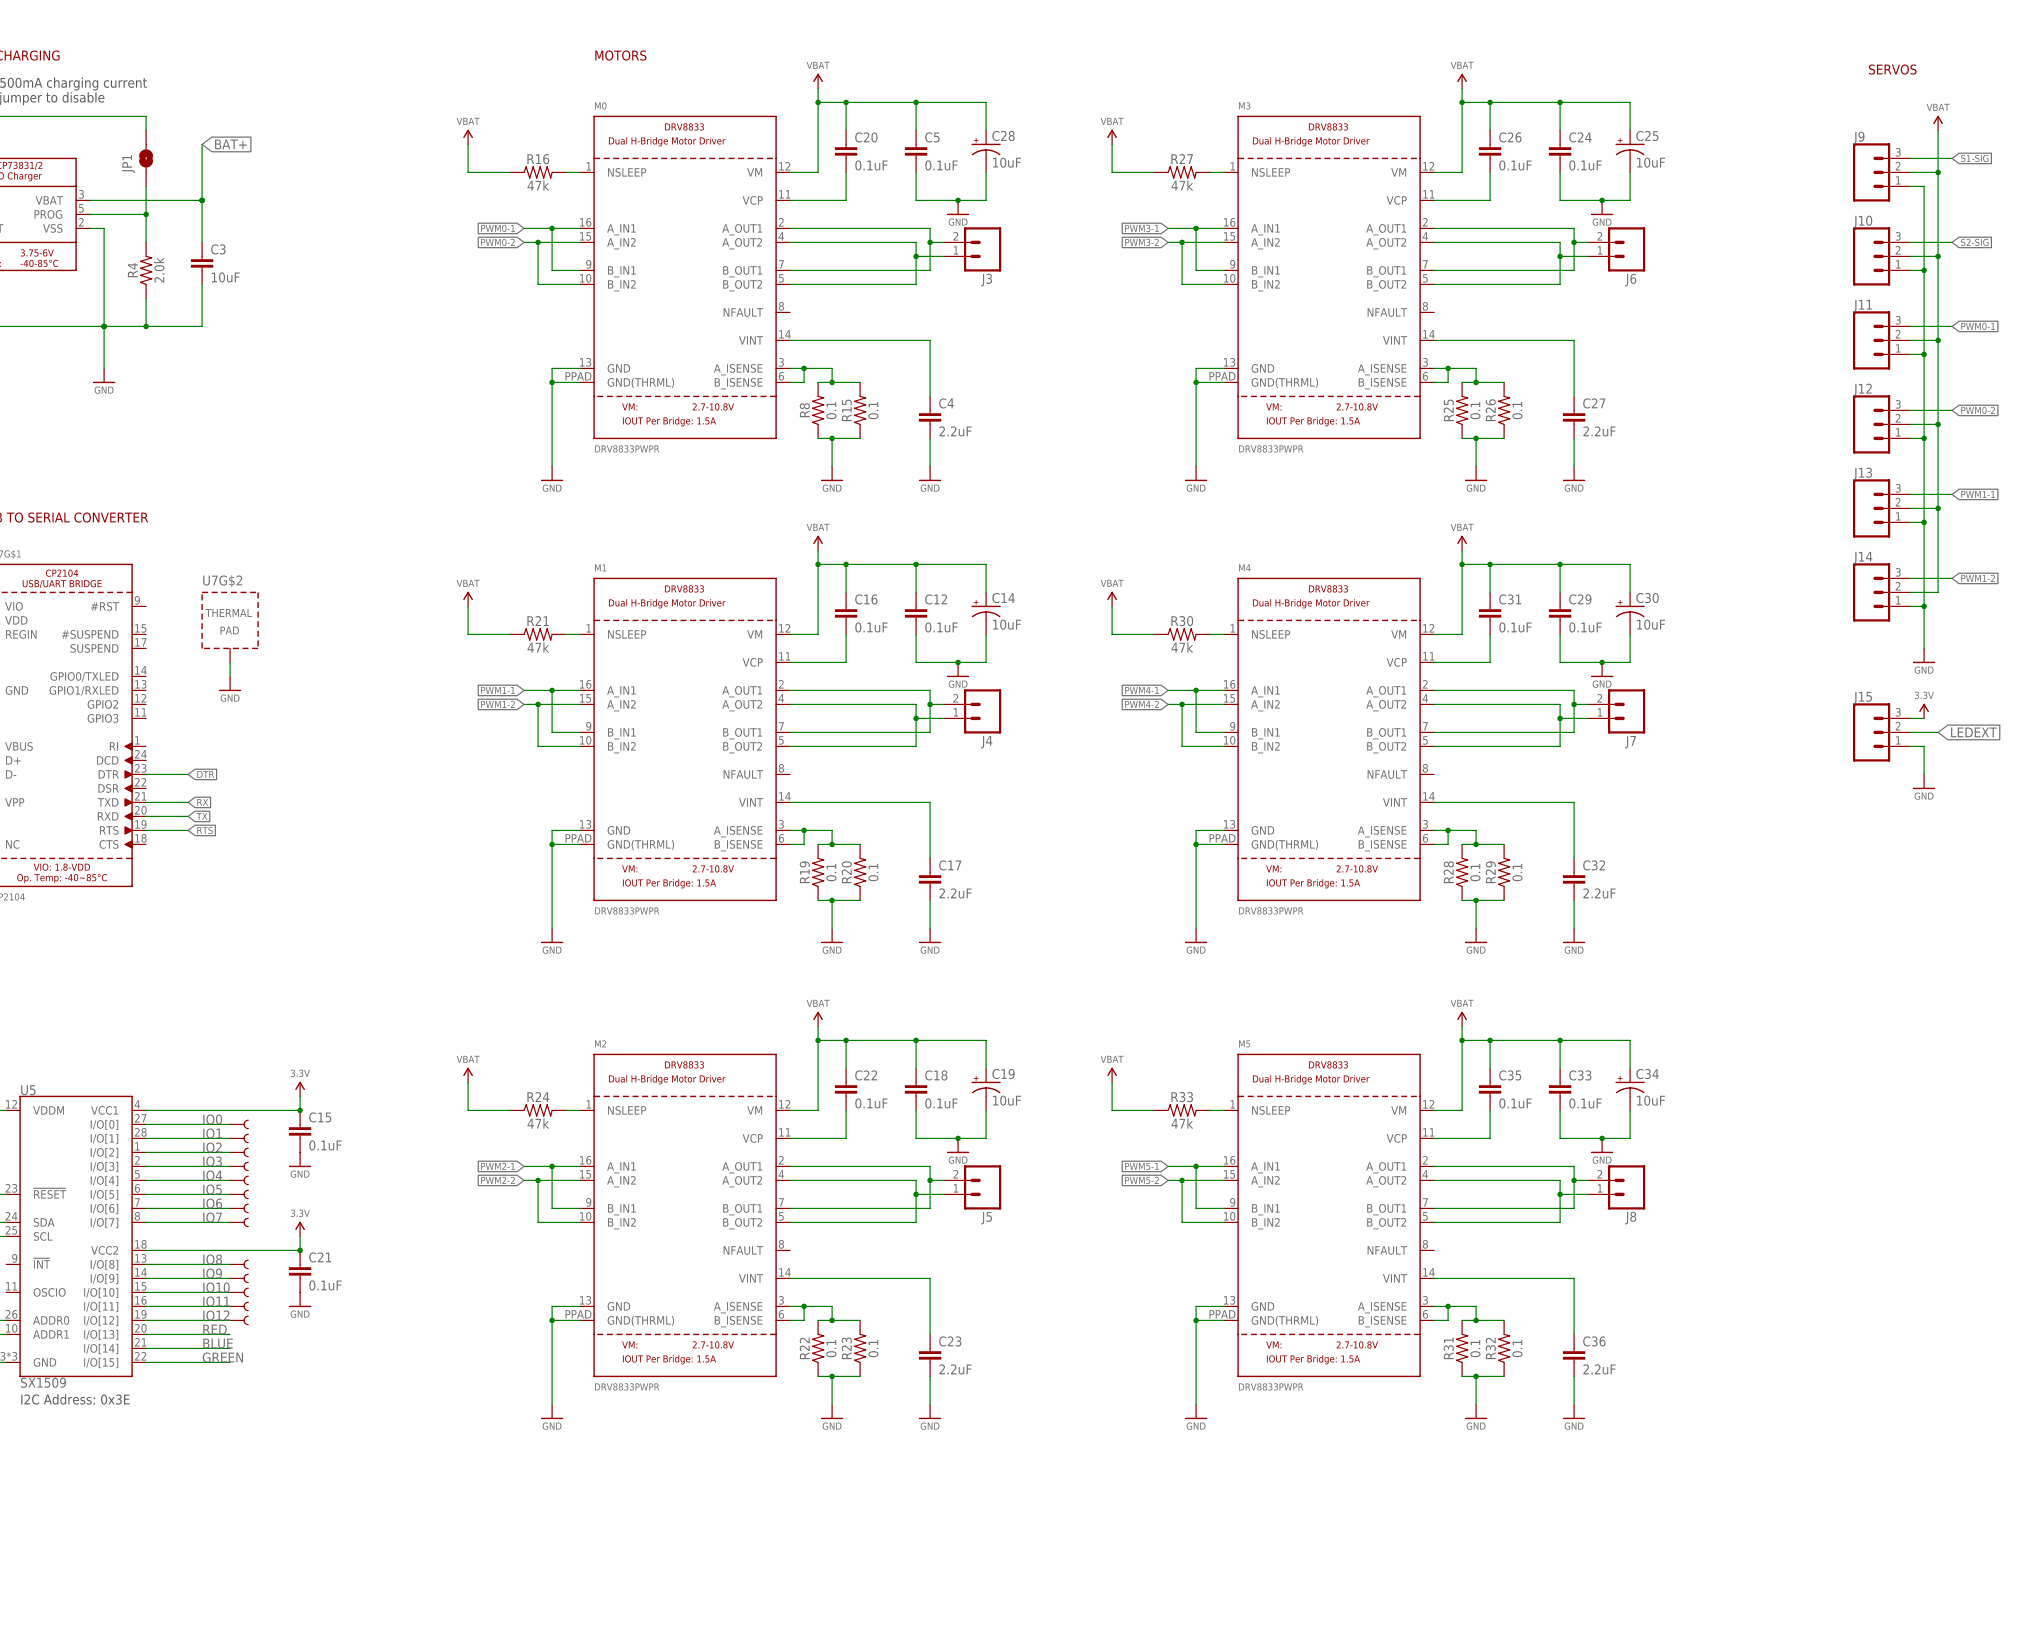
[picture p117: schematic blimpy-2.1.sch, part in row 1, column 2]

Parts:
C1: 470nF; 0603
C2, C3, C6, C8, C9: 10uF; 0603
C4, C10, C17, C23, C27, C32, C36: 2.2uF; 0603
C5, C11, C12, C13, C15, C16, C18, C20, C21, C22, C24, C26, C29, C31, C33, C35: 0.1uF; 0603
C7: 1.0uF; 0603
C14, C19, C25, C28, C30, C34: 10uF; EIA3216
D1: 1A/23V/620mV; SOD-323
D2: ORANGE; CHIPLED_0805_NOOUTLINE
D3: BAS70-05; SOT23
D4, D5, D6: GREEN; CHIPLED_0805_NOOUTLINE
J1: MICRO-USB; USB-MICROB
J2: CONN_02PTH4; 1X02_XTRA_BIG
J3, J4, J5, J6, J7, J8: CONN_02-JST-2MM-SMT; JST-2-SMD
J9, J10, J11, J12, J13, J14, J15: 3-PIN SMD; JST-3-SMD
JP1, JP2: JUMPER-SMT_2_NO_SILK; SMT-JUMPER_2_NO_SILK
M0, M1, M2, M3, M4, M5: DRV8833PWPR; HTSSOP16
Q1, Q2, Q5: 600mA/40V; SOT23-3
Q3: DMG3415U; SOT23-R
Q4: 6.5A/20V/35mΩ; SO08
R1: 10; 0603
R2, R5, R6, R7: 1k; 0603
R3: 0.005; 1206
R4: 2.0k; 0603
R8, R15, R19, R20, R22, R23, R25, R26, R28, R29, R31, R32: 0.1; 1206
R9, R10, R11: 10k; 0603
R12: 100k; 0603
R13, R14, R18, R38: 4.7k; 0603
R16, R21, R24, R27, R30, R33: 47k; 0603
R17: 1M; 0603
R34: CB61F
R35, R36, R37: 0603
S1: EVQPUJ02K
TP1, TP2, TP3, TP4, TP5, TP6, TP7, TP8, TP9, TP10, TP11, TP12, TP13, TP14, TP15, TP16, TP17, TP18, TP19, TP20, TP21, TP22, TP23, TP24, TP25, TP26, TP27, TP28, TP29, TP30, TP31, TP32, TP33, TP34, TP35, TP36, TP37, TP38, TP39: TEST-POINT3; PAD.03X.03
U1: PARTICLE_RGB-LED-CLMVB-FKARGB; PARTICLE_PLCC4-2MM-RGB
U2: AP2112-3.3; SOT23-5
U3: MICROBUILDER_MCP73831/2; MICROBUILDER_SOT23-5
U4: MAX17201G+; 21-0137I_T1433-1_MXM
U5: SX1509; QFN-28
U7: CP2104; QFN24_4MM_SMSC
U9: ESP-WROOM-32

Connections:
3.3V: C2.1, C7.1, C8.1, C13.1, C15.1, C21.1, D6.A, J15.3, R11.2, R13.2, R14.1, R38.2, TP11.P$1, U1.CA (1), U2.5 (OUT), U5.4 (VCC1), U5.12 (VDDM), U5.18 (VCC2), U7.5 (VIO), U7.6 (VDD), U7.7 (REGIN), U9.2 (3V3)
BAT+: C3.1, J2.1, R34.1, U3.3 (VBAT)
BAT-: J2.2, R3.2, U4.2 (CSP)
BLUE: R7.2, U5.21 (I/O[14])
BOOT-SEL: Q2.3 (C), U9.25 (0-DTR)
BTN: D3.2 (A2), R38.1, TP8.P$1, U9.6 (34-IA)
CHIP-EN: Q1.3 (C), R11.1, U9.3 (EN-RTS)
DTR: Q2.2 (E), R10.1, U7.23 (DTR)
GND: C1.2, C2.2, C3.2, C4.2, C5.2, C6.2, C7.2, C8.2, C9.2, C11.2, C12.2, C13.2, C14.-, C15.2, C17.2, C18.2, C19.-, C21.2, C23.2, C24.2, C25.-, C27.2, C28.-, C29.2, C30.-, C32.2, C33.2, C34.-, C36.2, J1.GND, J1.MT1 (SHIELD), J1.MT2 (SHIELD), J1.P$1 (SHIELD), J1.P$2 (SHIELD), J9.1, J10.1, J11.1, J12.1, J13.1, J14.1, J15.1, M0.13 (GND), M0.PPAD (GND(THRML)), M1.13 (GND), M1.PPAD (GND(THRML)), M2.13 (GND), M2.PPAD (GND(THRML)), M3.13 (GND), M3.PPAD (GND(THRML)), M4.13 (GND), M4.PPAD (GND(THRML)), M5.13 (GND), M5.PPAD (GND(THRML)), Q5.2 (E), R3.1, R4.1, R8.1, R12.1, R15.1, R19.1, R20.1, R22.1, R23.1, R25.1, R26.1, R28.1, R29.1, R31.1, R32.1, R35.2, R36.2, R37.2, S1.1, S1.3 (1), TP12.P$1, TP13.P$1, U2.2 (GND), U3.2 (VSS), U4.4 (CSN), U4.15, U5.3 (GND), U5.10 (ADDR1), U5.17 (GND), U5.26 (ADDR0), U5.29 (GND), U7.2 (GND), U7.THERM (TP), U9.1 (GND), U9.15 (GND), U9.38 (GND), U9.GND
GREEN: R6.2, U5.22 (I/O[15])
IO0: TP27.P$1, U5.27 (I/O[0])
IO1: TP28.P$1, U5.28 (I/O[1])
IO1-RST: TP26.P$1, U5.23 (!RESET), U9.24 (2)
IO2: TP29.P$1, U5.1 (I/O[2])
IO3: TP30.P$1, U5.2 (I/O[3])
IO4: TP31.P$1, U5.5 (I/O[4])
IO5: TP32.P$1, U5.6 (I/O[5])
IO6: TP33.P$1, U5.7 (I/O[6])
IO7: TP34.P$1, U5.8 (I/O[7])
IO8: TP35.P$1, U5.13 (I/O[8])
IO9: TP36.P$1, U5.14 (I/O[9])
IO10: TP37.P$1, U5.15 (I/O[10])
IO11: TP38.P$1, U5.16 (I/O[11])
IO12: TP39.P$1, U5.19 (I/O[12])
LEDEXT: J15.2, TP5.P$1, U9.13 (14-IO)
unnamed: D2.C, R2.1
unnamed: J1.D+, U7.3 (D+)
unnamed: R2.2, U3.1 (STAT)
unnamed: JP1.1, R4.2, U3.5 (PROG)
unnamed: M0.1 (NSLEEP), R16.2
unnamed: J1.D-, U7.4 (D-)
unnamed: C6.1, D1.C, Q3.2 (S), U2.1 (IN), U2.3 (EN)
unnamed: C1.1, U4.3 (REG2)
unnamed: R5.1, U1.RED (4)
unnamed: R7.1, U1.BLUE (2)
unnamed: R6.1, U1.GREEN (3)
unnamed: Q1.1 (B), R10.2
unnamed: Q2.1 (B), R9.2
unnamed: M0.3 (A_ISENSE), M0.6 (B_ISENSE), R8.2, R15.2
unnamed: C11.1, R1.2, U4.1 (REG3), U4.5 (VBATT), U4.6 (CELL2), U4.7 (CELL1), U4.13 (CELLX)
unnamed: C10.2, D3.1 (A1), Q4.4 (G), Q5.3 (C), R17.1
unnamed: D4.C, R37.1
unnamed: C10.1, Q4.1 (S), Q4.2 (S), Q4.3 (S), R17.2, R34.2
unnamed: TP9.P$1, U9.5 (39-I)
unnamed: D1.A, JP2.1, Q3.1 (G), R12.2
unnamed: TP7.P$1, U9.7 (35-IA)
unnamed: D3.3 (C), S1.2, S1.4 (2)
unnamed: Q5.1 (B), R18.1
unnamed: J4.1 (2), M1.4 (A_OUT2), M1.5 (B_OUT2)
unnamed: J4.2 (1), M1.2 (A_OUT1), M1.7 (B_OUT1)
unnamed: C17.1, M1.14 (VINT)
unnamed: C16.2, M1.11 (VCP)
unnamed: M1.3 (A_ISENSE), M1.6 (B_ISENSE), R19.2, R20.2
unnamed: M1.1 (NSLEEP), R21.2
unnamed: J6.1 (2), M3.4 (A_OUT2), M3.5 (B_OUT2)
unnamed: J5.1 (2), M2.4 (A_OUT2), M2.5 (B_OUT2)
unnamed: C23.1, M2.14 (VINT)
unnamed: C22.2, M2.11 (VCP)
unnamed: M2.3 (A_ISENSE), M2.6 (B_ISENSE), R22.2, R23.2
unnamed: M2.1 (NSLEEP), R24.2
unnamed: J6.2 (1), M3.2 (A_OUT1), M3.7 (B_OUT1)
unnamed: J3.2 (1), M0.2 (A_OUT1), M0.7 (B_OUT1)
unnamed: J7.1 (2), M4.4 (A_OUT2), M4.5 (B_OUT2)
unnamed: C27.1, M3.14 (VINT)
unnamed: C26.2, M3.11 (VCP)
unnamed: M3.3 (A_ISENSE), M3.6 (B_ISENSE), R25.2, R26.2
unnamed: M3.1 (NSLEEP), R27.2
unnamed: J8.2 (1), M5.2 (A_OUT1), M5.7 (B_OUT1)
unnamed: J7.2 (1), M4.2 (A_OUT1), M4.7 (B_OUT1)
unnamed: C32.1, M4.14 (VINT)
unnamed: C31.2, M4.11 (VCP)
unnamed: M4.3 (A_ISENSE), M4.6 (B_ISENSE), R28.2, R29.2
unnamed: J5.2 (1), M2.2 (A_OUT1), M2.7 (B_OUT1)
unnamed: M4.1 (NSLEEP), R30.2
unnamed: J8.1 (2), M5.4 (A_OUT2), M5.5 (B_OUT2)
unnamed: D6.C, R36.1
unnamed: C36.1, M5.14 (VINT)
unnamed: C35.2, M5.11 (VCP)
unnamed: M5.3 (A_ISENSE), M5.6 (B_ISENSE), R31.2, R32.2
unnamed: M5.1 (NSLEEP), R33.2
unnamed: D5.C, R35.1
unnamed: TP10.P$1, U9.4 (36-I)
unnamed: J3.1 (2), M0.4 (A_OUT2), M0.5 (B_OUT2)
unnamed: C4.1, M0.14 (VINT)
unnamed: C20.2, M0.11 (VCP)
PWM0-1: J11.3, M0.9 (B_IN1), M0.16 (A_IN1), TP1.P$1, U9.8 (32-IOA)
PWM0-2: J12.3, M0.10 (B_IN2), M0.15 (A_IN2), TP2.P$1, U9.9 (33-IOA)
PWM1-1: J13.3, M1.9 (B_IN1), M1.16 (A_IN1), TP3.P$1, U9.10 (25-IOD)
PWM1-2: J14.3, M1.10 (B_IN2), M1.15 (A_IN2), TP6.P$1, U9.11 (26-IOD)
PWM2-1: M2.9 (B_IN1), M2.16 (A_IN1), TP17.P$1, U9.12 (27-IO)
PWM2-2: M2.10 (B_IN2), M2.15 (A_IN2), TP23.P$1, U9.16 (13-IO)
PWM3-1: M3.9 (B_IN1), M3.16 (A_IN1), TP16.P$1, U9.26 (4-IO)
PWM3-2: M3.10 (B_IN2), M3.15 (A_IN2), TP15.P$1, U9.27 (16-IO)
PWM4-1: M4.9 (B_IN1), M4.16 (A_IN1), TP22.P$1, U9.28 (17-IO)
PWM4-2: M4.10 (B_IN2), M4.15 (A_IN2), TP21.P$1, U9.30 (18-IO)
PWM5-1: M5.9 (B_IN1), M5.16 (A_IN1), TP20.P$1, U9.31 (19-IO)
PWM5-2: M5.10 (B_IN2), M5.15 (A_IN2), TP14.P$1, U9.37 (23-IO)
PWR: R18.2, TP4.P$1, U9.14 (12)
RED: R5.2, U5.20 (I/O[13])
RTS: Q1.2 (E), R9.1, U7.19 (RTS)
RX: U7.21 (TXD), U9.34 (RX)
S1-SIG: J9.3, TP24.P$1, U9.23 (15)
S2-SIG: J10.3, TP25.P$1, U9.29 (5)
SCL: R14.2, TP18.P$1, U4.11 (OD/SCL), U5.25 (SCL), U9.36 (22-IO)
SDA: R13.1, TP19.P$1, U4.12 (DQ/SDA), U5.24 (SDA), U9.33 (21-IO)
TX: U7.20 (RXD), U9.35 (TX)
V_BATT: C5.1, C12.1, C14.+, C16.1, C18.1, C19.+, C20.1, C22.1, C24.1, C25.+, C26.1, C28.+, C29.1, C30.+, C31.1, C33.1, C34.+, C35.1, D5.A, J9.2, J10.2, J11.2, J12.2, J13.2, J14.2, M0.12 (VM), M1.12 (VM), M2.12 (VM), M3.12 (VM), M4.12 (VM), M5.12 (VM), Q3.3 (D), Q4.5 (D), Q4.6 (D), Q4.7 (D), Q4.8 (D), R1.1, R16.1, R21.1, R24.1, R27.1, R30.1, R33.1
V_USB: C9.1, D2.A, D4.A, J1.VBUS, JP1.2, JP2.2, U3.4 (VDD), U7.8 (VBUS)

Notes on the sheet:
BOARD POWER
up to 500mA charging current close jumper to disable
USB TO SERIAL CONVERTER
LIPO CHARGING
RGB LED
PROGRAMMING
CHARGING LED
I2C Address: 0x6C
I2C PULL-UP RESISTORS
WIFI/BLE SOC
GPIO Expander 1
600mA (800mA max)
SERVOS
MOTORS
Blimpy Board 2.1 Immersive Arts Space ZHdK - Joël Gähwiler, Max Kriegleder
BATTERY STATE OF CHARGE MEASUREMENT
I2C Address: 0x3E
MAIN SWITCH
10A Fuse

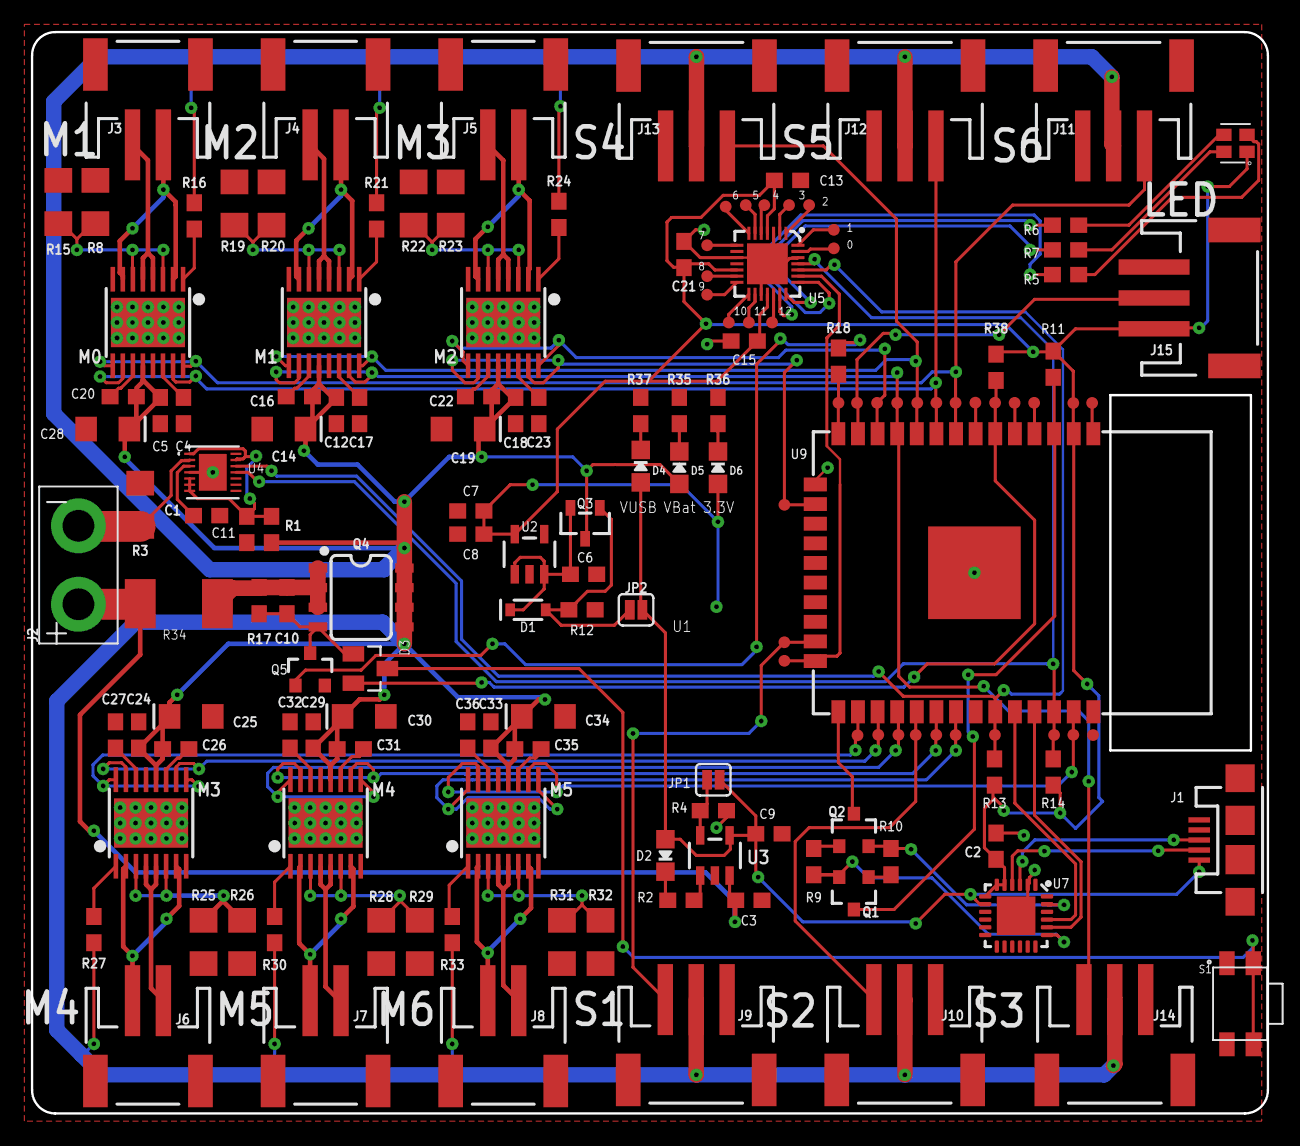
[picture p118: board blimpy-2.1.brd from above]

Board: 2 copper layers, 80.0 x 70.0 mm, 155 parts (0 on the bottom side), 108 nets.
