immersive-arts/Blimpy/robots/blimpy/design/electronics/pcb/blimpy-1.0-B.brd

## EAGLE design robots/blimpy/design/electronics/pcb/blimpy-1.0-B.brd (2019-11-17)

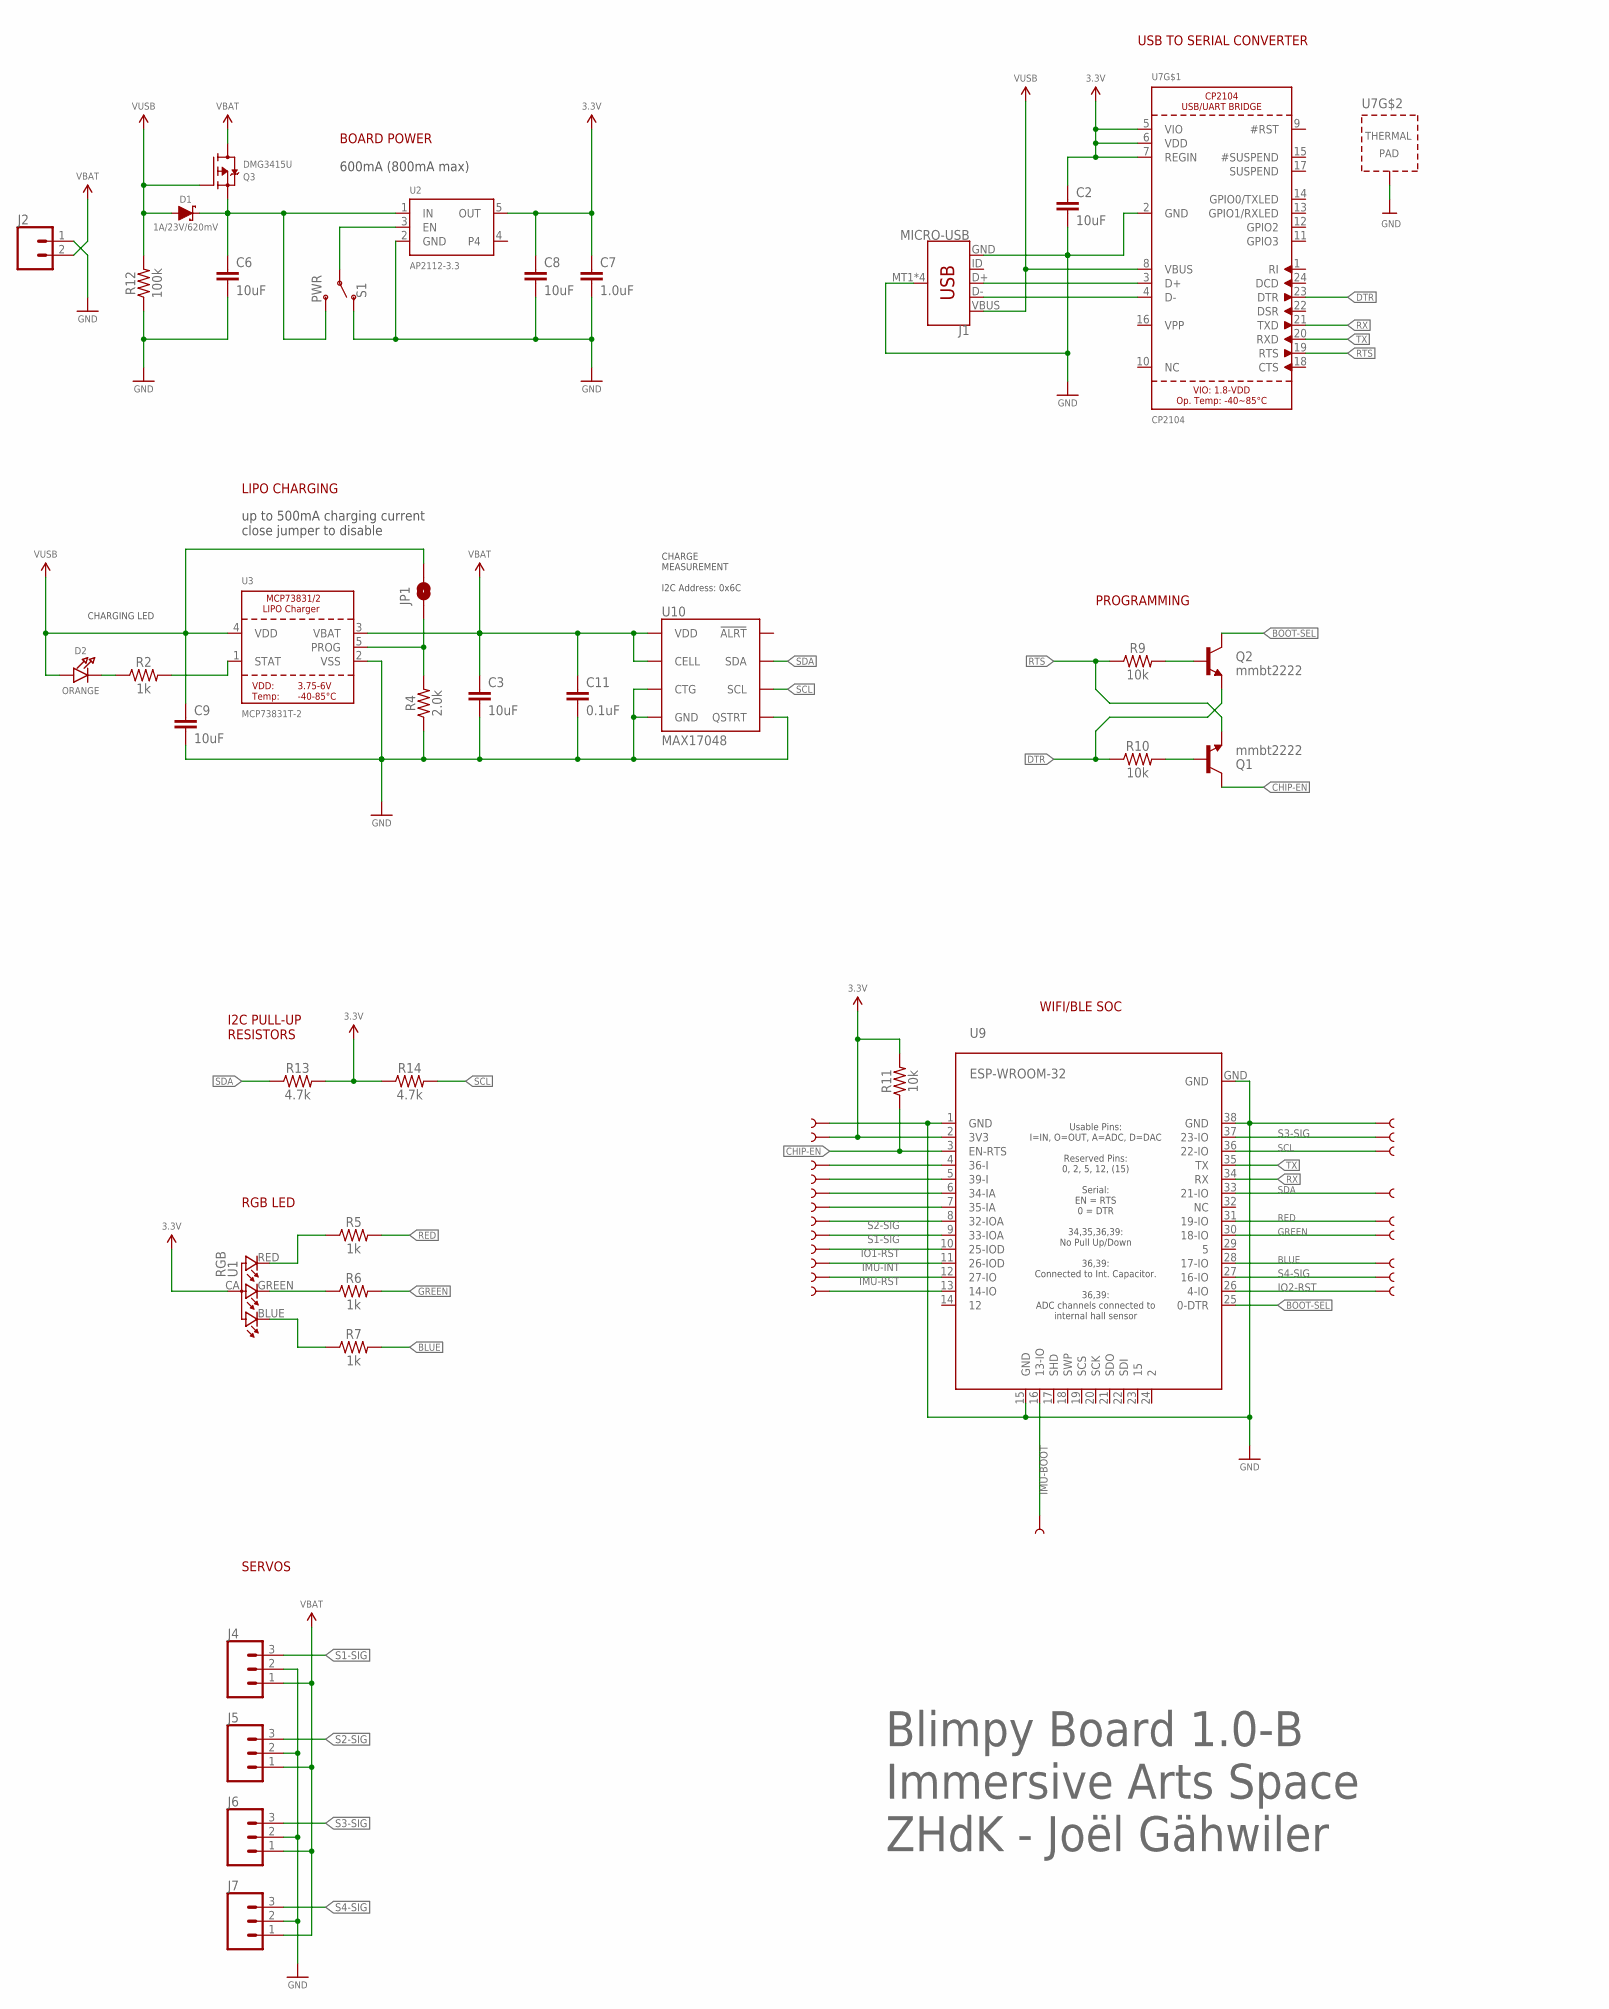
[picture p119: schematic blimpy-1.0-B.sch, part in row 1, column 1]

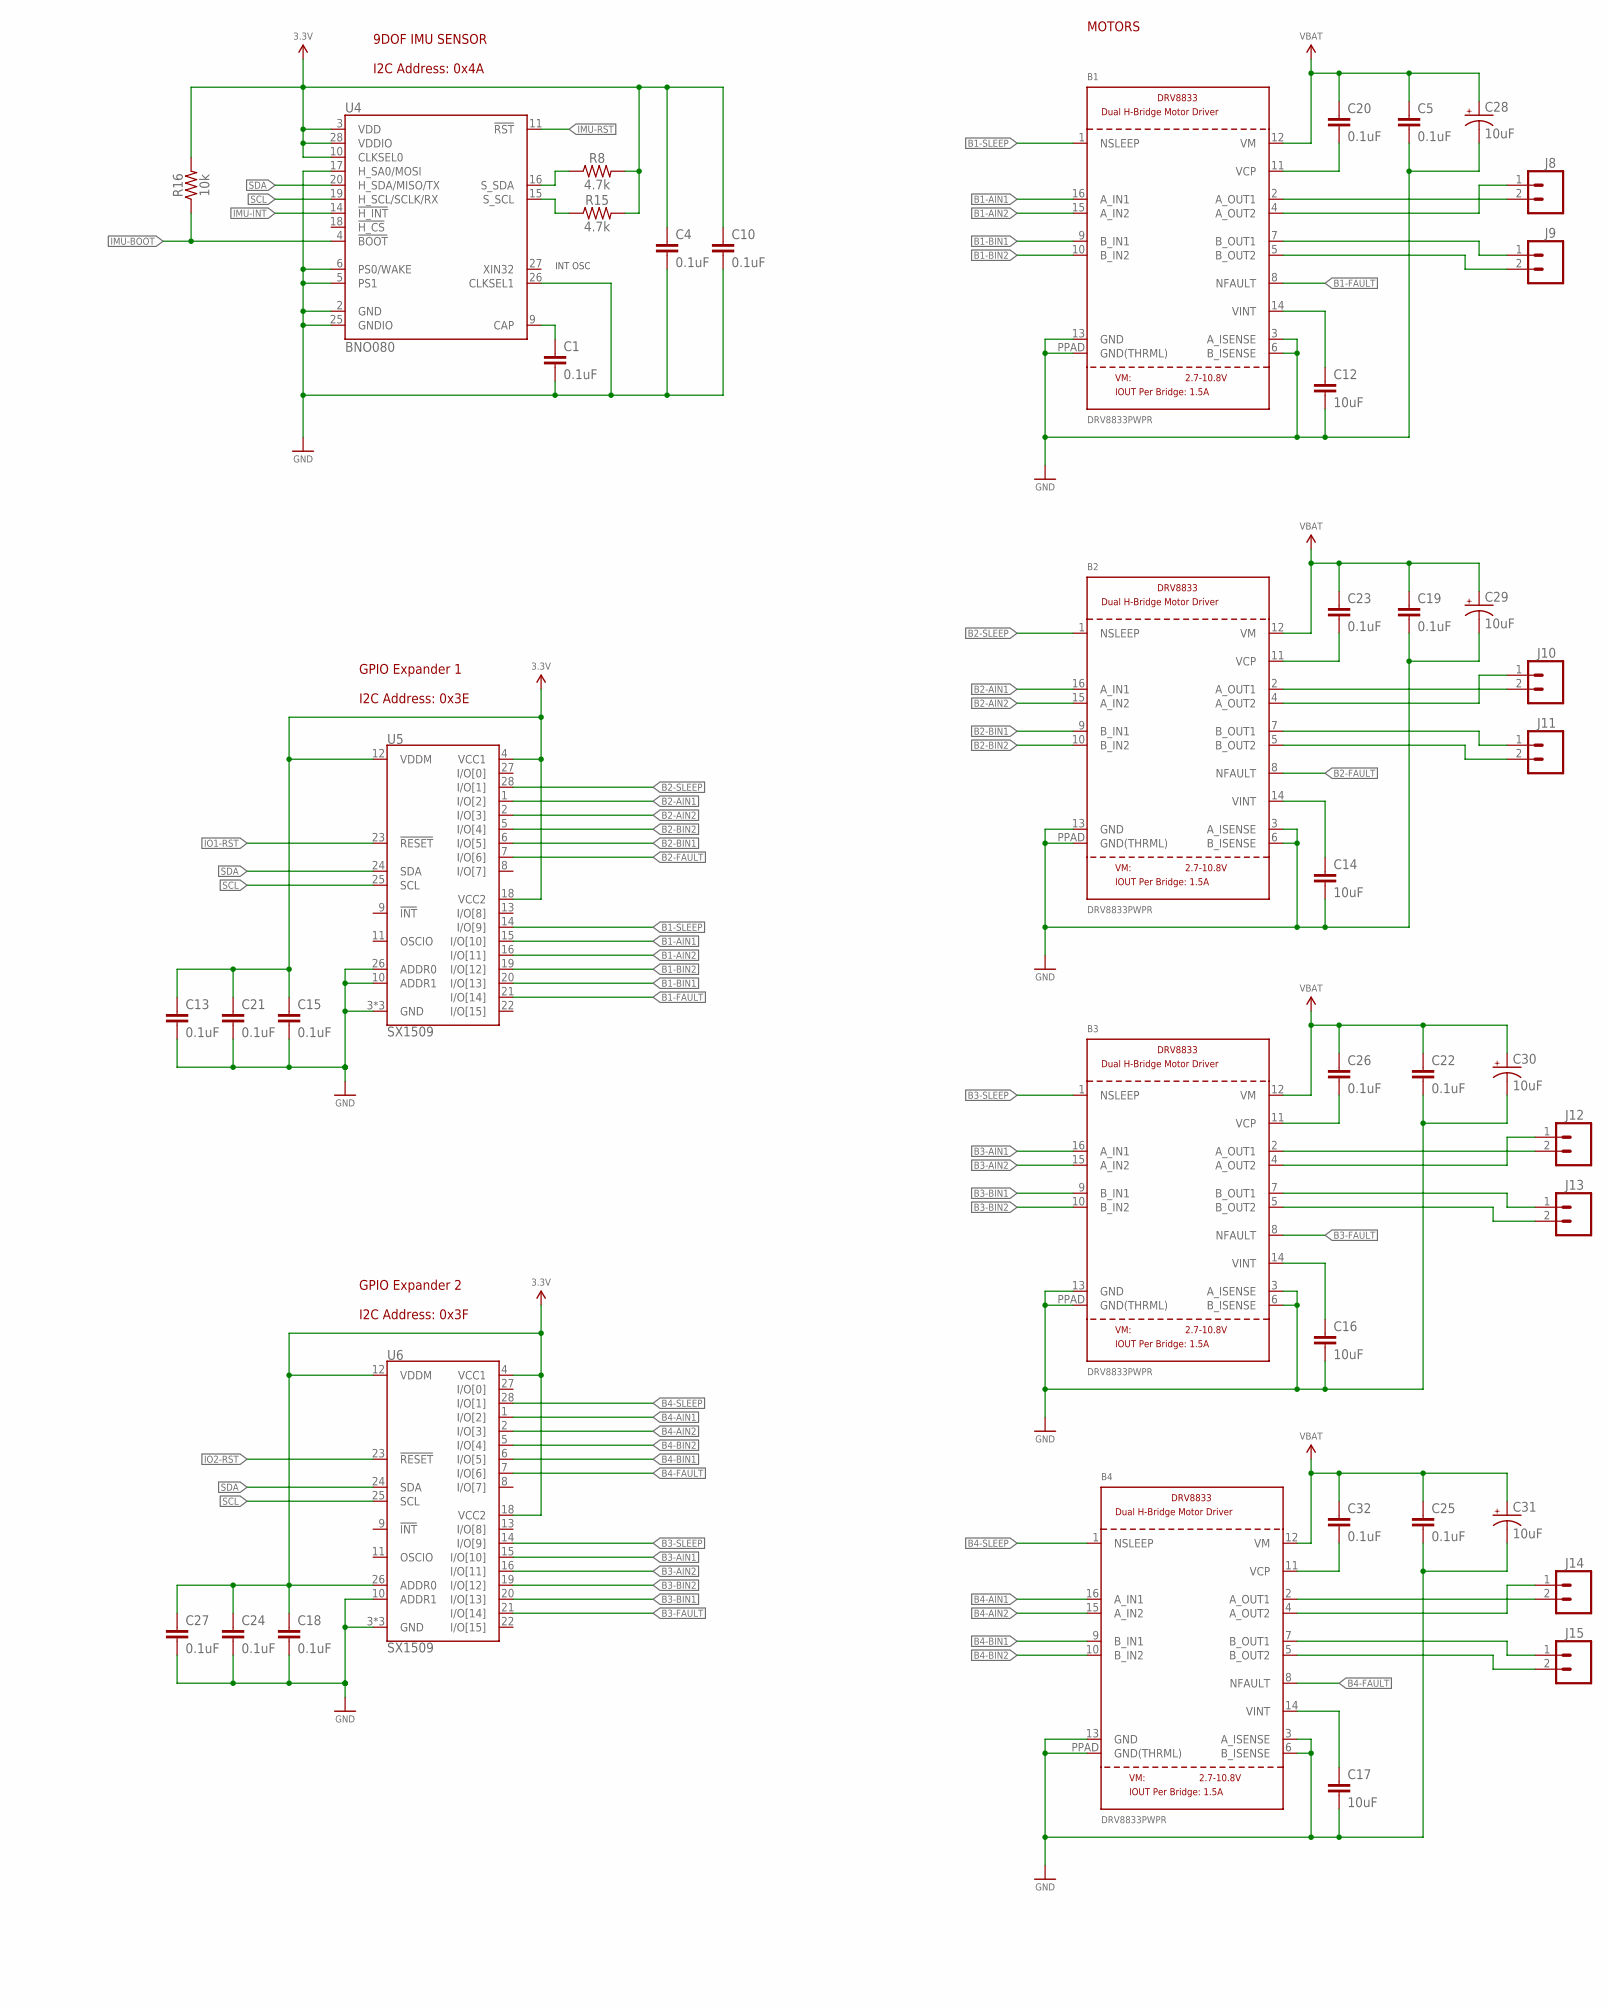
[picture p120: schematic blimpy-1.0-B.sch, part in row 1, column 2]

Parts:
B1, B2, B3, B4: DRV8833PWPR; HTSSOP16
C1, C4, C5, C10, C11, C13, C15, C18, C19, C20, C21, C22, C23, C24, C25, C26, C27, C32: 0.1uF; 0603
C2, C3, C6, C8, C9, C12, C14, C16, C17: 10uF; 0603
C7: 1.0uF; 0603
C28, C29, C30, C31: 10uF; EIA3216
D1: 1A/23V/620mV; SOD-323
D2: ORANGE; CHIPLED_0805_NOOUTLINE
J1: MICRO-USB; USB-MICROB
J2, J8, J9, J10, J11, J12, J13, J14, J15: CONN_02-JST-2MM-SMT; JST-2-SMD
J4, J5, J6, J7: 3-PIN SMD; JST-3-SMD
JP1: JUMPER-SMT_2_NO_SILK; SMT-JUMPER_2_NO_SILK
Q1, Q2: mmbt2222; SOT23-3
Q3: DMG3415U; SOT23-R
R2, R5, R6, R7: 1k; 0603
R4: 2.0k; 0603
R8, R13, R14, R15: 4.7k; 0603
R9, R10, R11, R16: 10k; 0603
R12: 100k; 0603
S1: PWR; SWITCH_SPST_SMD_A
TP1, TP2, TP3, TP4, TP5, TP6, TP7, TP8, TP9, TP10, TP11, TP12, TP13, TP14, TP15, TP16, TP17, TP18, TP19, TP20, TP21, TP22: TEST-POINT3; PAD.03X.03
U1: RGB; PLCC4-2MM-RGB
U2: AP2112-3.3; SOT23-5
U3: MCP73831T-2; SOT23-5
U4: BNO080; LGA-28
U5, U6: SX1509; QFN-28
U7: CP2104; QFN24_4MM_SMSC
U9: ESP-WROOM-32
U10: MAX17048; DFN-8

Connections:
3.3V: C2.1, C4.1, C7.1, C8.1, C10.1, C13.1, C15.1, C18.1, C21.1, C24.1, C27.1, R8.2, R11.2, R13.2, R14.1, R15.2, R16.2, TP11.P$1, U1.CA (1), U2.5 (OUT), U4.3 (VDD), U4.10 (CLKSEL0), U4.28 (VDDIO), U5.4 (VCC1), U5.12 (VDDM), U5.18 (VCC2), U6.4 (VCC1), U6.12 (VDDM), U6.18 (VCC2), U6.26 (ADDR0), U7.5 (VIO), U7.6 (VDD), U7.7 (REGIN), U9.2 (3V3)
B1-AIN1: B1.16 (A_IN1), U5.15 (I/O[10])
B1-AIN2: B1.15 (A_IN2), U5.16 (I/O[11])
B1-BIN1: B1.9 (B_IN1), U5.20 (I/O[13])
B1-BIN2: B1.10 (B_IN2), U5.19 (I/O[12])
B1-FAULT: B1.8 (NFAULT), U5.21 (I/O[14])
B1-SLEEP: B1.1 (NSLEEP), U5.14 (I/O[9])
B2-AIN1: B2.16 (A_IN1), U5.1 (I/O[2])
B2-AIN2: B2.15 (A_IN2), U5.2 (I/O[3])
B2-BIN1: B2.9 (B_IN1), U5.6 (I/O[5])
B2-BIN2: B2.10 (B_IN2), U5.5 (I/O[4])
B2-FAULT: B2.8 (NFAULT), U5.7 (I/O[6])
B2-SLEEP: B2.1 (NSLEEP), U5.28 (I/O[1])
B3-AIN1: B3.16 (A_IN1), U6.15 (I/O[10])
B3-AIN2: B3.15 (A_IN2), U6.16 (I/O[11])
B3-BIN1: B3.9 (B_IN1), U6.20 (I/O[13])
B3-BIN2: B3.10 (B_IN2), U6.19 (I/O[12])
B3-FAULT: B3.8 (NFAULT), U6.21 (I/O[14])
B3-SLEEP: B3.1 (NSLEEP), U6.14 (I/O[9])
B4-AIN1: B4.16 (A_IN1), U6.1 (I/O[2])
B4-AIN2: B4.15 (A_IN2), U6.2 (I/O[3])
B4-BIN1: B4.9 (B_IN1), U6.6 (I/O[5])
B4-BIN2: B4.10 (B_IN2), U6.5 (I/O[4])
B4-FAULT: B4.8 (NFAULT), U6.7 (I/O[6])
B4-SLEEP: B4.1 (NSLEEP), U6.28 (I/O[1])
BLUE: R7.2, TP22.P$1, U9.28 (17-IO)
BOOT-SEL: Q2.3 (C), U9.25 (0-DTR)
CHIP-EN: Q1.3 (C), R11.1, U9.3 (EN-RTS)
DTR: Q2.2 (E), R10.1, U7.23 (DTR)
GND: B1.3 (A_ISENSE), B1.6 (B_ISENSE), B1.13 (GND), B1.PPAD (GND(THRML)), B2.3 (A_ISENSE), B2.6 (B_ISENSE), B2.13 (GND), B2.PPAD (GND(THRML)), B3.3 (A_ISENSE), B3.6 (B_ISENSE), B3.13 (GND), B3.PPAD (GND(THRML)), B4.3 (A_ISENSE), B4.6 (B_ISENSE), B4.13 (GND), B4.PPAD (GND(THRML)), C1.2, C2.2, C3.2, C4.2, C5.2, C6.2, C7.2, C8.2, C9.2, C10.2, C11.2, C12.2, C13.2, C14.2, C15.2, C16.2, C17.2, C18.2, C19.2, C21.2, C22.2, C24.2, C25.2, C27.2, C28.-, C29.-, C30.-, C31.-, J1.GND, J1.MT1 (SHIELD), J1.MT2 (SHIELD), J1.P$1 (SHIELD), J1.P$2 (SHIELD), J2.1 (2), J4.2, J5.2, J6.2, J7.2, R4.1, R12.1, S1.1 (O), TP12.P$1, TP13.P$1, U2.2 (GND), U3.2 (VSS), U4.2 (GND), U4.5 (PS1), U4.6 (PS0/WAKE), U4.17 (H_SA0/MOSI), U4.25 (GNDIO), U4.26 (CLKSEL1), U5.3 (GND), U5.10 (ADDR1), U5.17 (GND), U5.26 (ADDR0), U5.29 (GND), U6.3 (GND), U6.10 (ADDR1), U6.17 (GND), U6.29 (GND), U7.2 (GND), U7.THERM (TP), U9.1 (GND), U9.15 (GND), U9.38 (GND), U9.GND, U10.P$1 (CTG), U10.P$4 (GND), U10.P$6 (QSTRT), U10.P$9 (GND)
GREEN: R6.2, TP21.P$1, U9.30 (18-IO)
IMU-BOOT: R16.1, TP17.P$1, U4.4 (!BOOT), U9.16 (13-IO)
IMU-INT: TP4.P$1, U4.14 (!H_INT), U9.11 (26-IOD)
IMU-RST: TP5.P$1, U4.11 (!RST), U9.12 (27-IO)
IO1-RST: TP3.P$1, U5.23 (!RESET), U9.10 (25-IOD)
IO2-RST: TP16.P$1, U6.23 (!RESET), U9.26 (4-IO)
unnamed: D2.C, R2.1
unnamed: J1.D+, U7.3 (D+)
unnamed: R2.2, U3.1 (STAT)
unnamed: JP1.1, R4.2, U3.5 (PROG)
unnamed: J1.D-, U7.4 (D-)
unnamed: C6.1, D1.C, Q3.2 (S), S1.3 (S), U2.1 (IN)
unnamed: S1.2, U2.3 (EN)
unnamed: R5.1, U1.RED (4)
unnamed: R7.1, U1.BLUE (2)
unnamed: R6.1, U1.GREEN (3)
unnamed: Q1.1 (B), R10.2
unnamed: Q2.1 (B), R9.2
unnamed: R8.1, U4.16 (S_SDA)
unnamed: R15.1, U4.15 (S_SCL)
unnamed: C1.1, U4.9 (CAP)
unnamed: TP10.P$1, U9.4 (36-I)
unnamed: TP9.P$1, U9.5 (39-I)
unnamed: TP8.P$1, U9.6 (34-IA)
unnamed: TP7.P$1, U9.7 (35-IA)
unnamed: TP6.P$1, U9.13 (14-IO)
unnamed: B1.2 (A_OUT1), J8.2 (1)
unnamed: B1.4 (A_OUT2), J8.1 (2)
unnamed: B1.7 (B_OUT1), J9.1 (2)
unnamed: B1.5 (B_OUT2), J9.2 (1)
unnamed: B2.2 (A_OUT1), J10.2 (1)
unnamed: B2.4 (A_OUT2), J10.1 (2)
unnamed: B2.7 (B_OUT1), J11.1 (2)
unnamed: B2.5 (B_OUT2), J11.2 (1)
unnamed: B3.2 (A_OUT1), J12.2 (1)
unnamed: B3.4 (A_OUT2), J12.1 (2)
unnamed: B3.7 (B_OUT1), J13.1 (2)
unnamed: B3.5 (B_OUT2), J13.2 (1)
unnamed: B4.2 (A_OUT1), J14.2 (1)
unnamed: B4.4 (A_OUT2), J14.1 (2)
unnamed: B4.7 (B_OUT1), J15.1 (2)
unnamed: B4.5 (B_OUT2), J15.2 (1)
unnamed: B1.14 (VINT), C12.1
unnamed: B2.14 (VINT), C14.1
unnamed: B4.14 (VINT), C17.1
unnamed: B1.11 (VCP), C20.2
unnamed: B3.14 (VINT), C16.1
unnamed: B2.11 (VCP), C23.2
unnamed: B3.11 (VCP), C26.2
unnamed: B4.11 (VCP), C32.2
RED: R5.2, TP20.P$1, U9.31 (19-IO)
RTS: Q1.2 (E), R9.1, U7.19 (RTS)
RX: U7.21 (TXD), U9.34 (RX)
S1-SIG: J4.3, TP2.P$1, U9.9 (33-IOA)
S2-SIG: J5.3, TP1.P$1, U9.8 (32-IOA)
S3-SIG: J6.3, TP14.P$1, U9.37 (23-IO)
S4-SIG: J7.3, TP15.P$1, U9.27 (16-IO)
SCL: R14.2, TP18.P$1, U4.19 (H_SCL/SCLK/RX), U5.25 (SCL), U6.25 (SCL), U9.36 (22-IO), U10.P$7 (SCL)
SDA: R13.1, TP19.P$1, U4.20 (H_SDA/MISO/TX), U5.24 (SDA), U6.24 (SDA), U9.33 (21-IO), U10.P$8 (SDA)
TX: U7.20 (RXD), U9.35 (TX)
V_BATT: B1.12 (VM), B2.12 (VM), B3.12 (VM), B4.12 (VM), C3.1, C5.1, C11.1, C19.1, C20.1, C22.1, C23.1, C25.1, C26.1, C28.+, C29.+, C30.+, C31.+, C32.1, J2.2 (1), J4.1, J5.1, J6.1, J7.1, Q3.3 (D), U3.3 (VBAT), U10.P$2 (CELL), U10.P$3 (VDD)
V_USB: C9.1, D1.A, D2.A, J1.VBUS, JP1.2, Q3.1 (G), R12.2, U3.4 (VDD), U7.8 (VBUS)

Notes on the sheet:
BOARD POWER
up to 500mA charging current close jumper to disable
USB TO SERIAL CONVERTER
LIPO CHARGING
RGB LED
PROGRAMMING
CHARGING LED
CHARGE MEASUREMENT I2C Address: 0x6C
I2C PULL-UP RESISTORS
WIFI/BLE SOC
9DOF IMU SENSOR I2C Address: 0x4A
INT OSC
GPIO Expander 1 I2C Address: 0x3E
GPIO Expander 2 I2C Address: 0x3F
600mA (800mA max)
SERVOS
MOTORS
Blimpy Board 1.0-B Immersive Arts Space ZHdK - Joël Gähwiler
