immersive-arts/Blimpy/robots/blimpy/design/electronics/pcb/blimpy-1.0-B.brd

## EAGLE design robots/blimpy/design/electronics/pcb/blimpy-1.0-B.brd (continued)

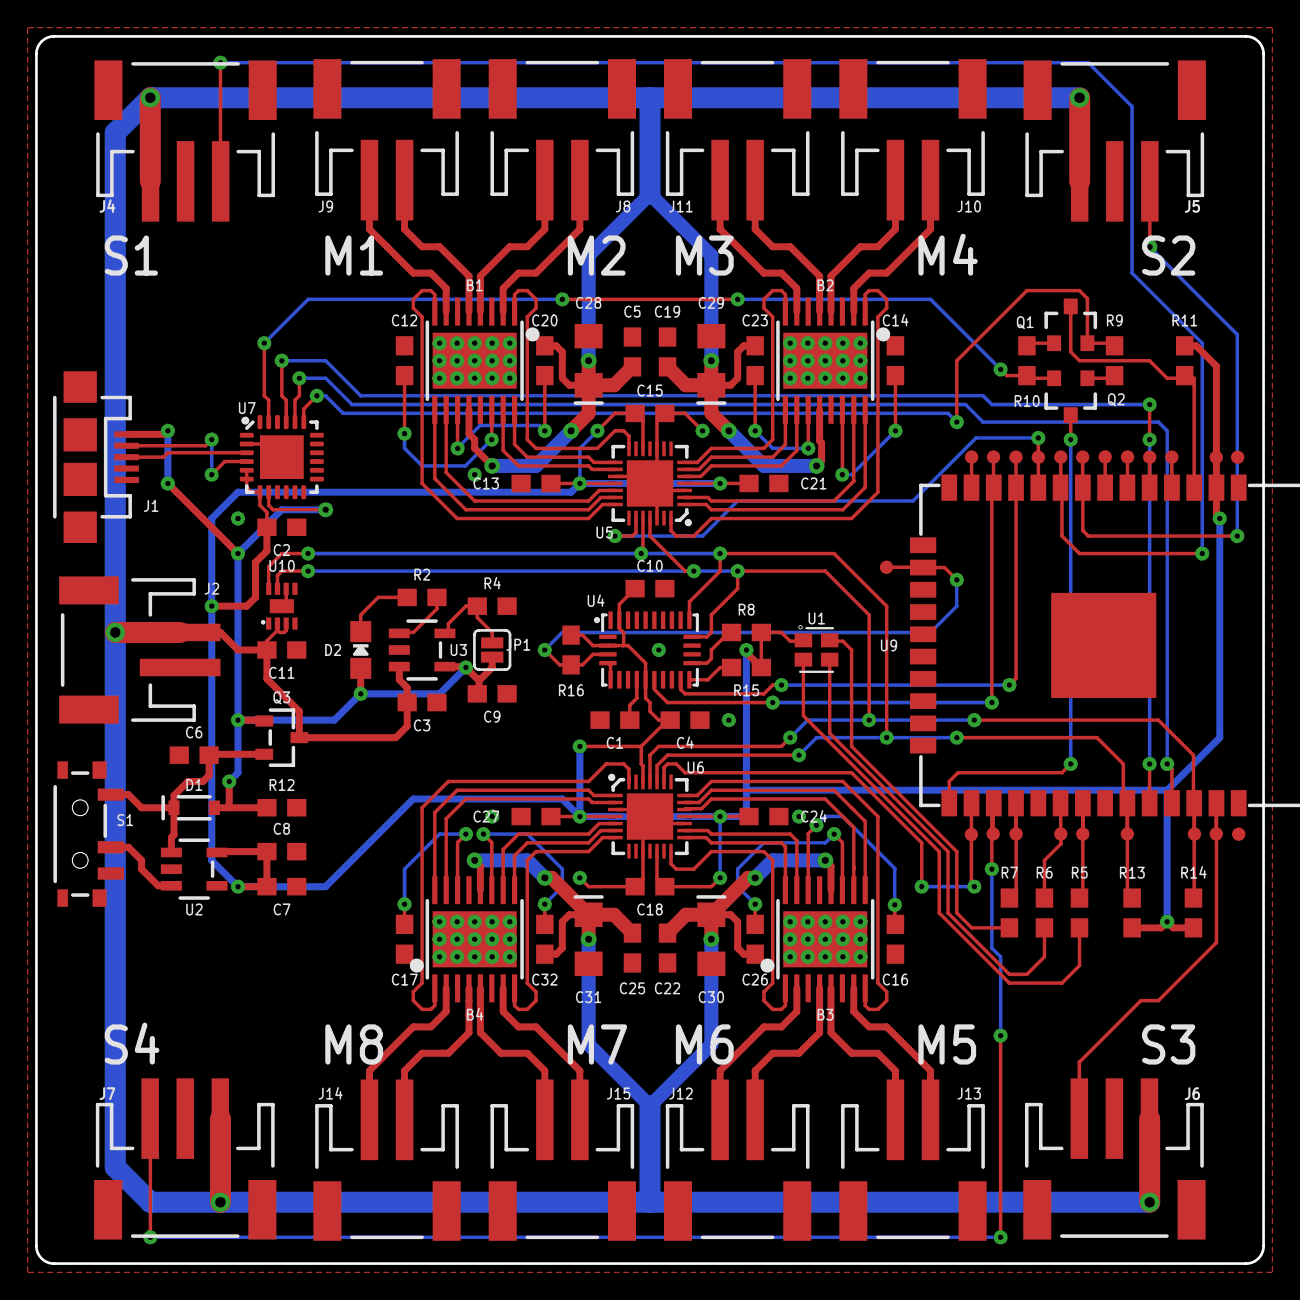
[picture p121: board blimpy-1.0-B.brd from above]

Board: 2 copper layers, 70.0 x 70.0 mm, 102 parts (0 on the bottom side), 92 nets.
