immersive-arts/Blimpy/robots/wheely/firmware/motor_controller/Moebius_stm32f103rct6_1.0.4/HardWare/ENCODER/encoder.c

#include "encoder.h"
  /**************************************************************************
作者：墨比斯科技
我的淘宝小店：https://moebius.taobao.com/
**************************************************************************/

/**************************************************************************
函数功能：把TIM2初始化为编码器接口模式
入口参数：无
返回  值：无
**************************************************************************/
void Encoder_Init_TIM2(void)
{
//	RCC->APB2ENR|=1<<0;    //开启辅助时钟
	AFIO->MAPR|=1<<8;      //01部分重映射
	RCC->APB1ENR|=1<<0;     //TIM2时钟使能
	RCC->APB2ENR|=1<<2;    //使能PORTA时钟
	RCC->APB2ENR|=1<<3;    //使能PORTB时钟
	GPIOA->CRH&=0X0FFFFFFF;//PA15
	GPIOA->CRH|=0X40000000;//浮空输入
	
	GPIOB->CRL&=0XFFFF0FFF;//PB3
	GPIOB->CRL|=0X00004000;//浮空输入
	TIM2->DIER|=1<<0;   //允许更新中断
	TIM2->DIER|=1<<6;   //允许触发中断
	MY_NVIC_Init(1,3,TIM2_IRQn,1);
	TIM2->PSC = 0x0;//预分频器
	TIM2->ARR = ENCODER_TIM_PERIOD;//设定计数器自动重装值 
	TIM2->CR1 &=~(3<<8);// 选择时钟分频：不分频
	TIM2->CR1 &=~(3<<5);// 选择计数模式:边沿对齐模式
		
	TIM2->CCMR1 |= 1<<0; //CC1S='01' IC1FP1映射到TI1
	TIM2->CCMR1 |= 1<<8; //CC2S='01' IC2FP2映射到TI2
	TIM2->CCER &= ~(1<<1);	 //CC1P='0'	 IC1FP1不反相，IC1FP1=TI1
	TIM2->CCER &= ~(1<<5);	 //CC2P='0'	 IC2FP2不反相，IC2FP2=TI2
//	TIM2->CCMR1 |= 3<<4; //	IC1F='1000' 输入捕获1滤波器
	TIM2->SMCR |= 3<<0;	 //SMS='011' 所有的输入均在上升沿和下降沿有效
	TIM2->CR1 |= 0x01;    //CEN=1，使能定时器
}
/**************************************************************************
函数功能：把TIM3初始化为编码器接口模式
入口参数：无
返回  值：无
**************************************************************************/
void Encoder_Init_TIM3(void)
{
	RCC->APB1ENR|=1<<1;     //TIM2时钟使能
	RCC->APB2ENR|=1<<3;    //使能PORTA时钟
	GPIOA->CRL&=0X00FFFFFF;//PA6 PA7
	GPIOA->CRL|=0X44000000;//浮空输入
	TIM3->DIER|=1<<0;   //允许更新中断				
	TIM3->DIER|=1<<6;   //允许触发中断
	MY_NVIC_Init(1,3,TIM3_IRQn,1);
	TIM3->PSC = 0x0;//预分频器
	TIM3->ARR = ENCODER_TIM_PERIOD;//设定计数器自动重装值 
	TIM3->CR1 &=~(3<<8);// 选择时钟分频：不分频
	TIM3->CR1 &=~(3<<5);// 选择计数模式:边沿对齐模式
		
	TIM3->CCMR1 |= 1<<0; //CC1S='01' IC1FP1映射到TI1
	TIM3->CCMR1 |= 1<<8; //CC2S='01' IC2FP2映射到TI2
	TIM3->CCER &= ~(1<<1);	 //CC1P='0'	 IC1FP1不反相，IC1FP1=TI1
	TIM3->CCER &= ~(1<<5);	 //CC2P='0'	 IC2FP2不反相，IC2FP2=TI2
//	TIM2->CCMR1 |= 3<<4; //	IC1F='1000' 输入捕获1滤波器
	TIM3->SMCR |= 3<<0;	 //SMS='011' 所有的输入均在上升沿和下降沿有效
	TIM3->CR1 |= 0x01;    //CEN=1，使能定时器
}
/**************************************************************************
函数功能：把TIM4初始化为编码器接口模式
入口参数：无
返回  值：无
**************************************************************************/
void Encoder_Init_TIM4(void)
{
	RCC->APB1ENR|=1<<2;     //TIM4时钟使能
	RCC->APB2ENR|=1<<3;     //使能PORTB时钟
	GPIOB->CRL&=0X00FFFFFF; //PB6 PB7
	GPIOB->CRL|=0X44000000; //浮空输入
	TIM4->DIER|=1<<0;   //允许更新中断				
	TIM4->DIER|=1<<6;   //允许触发中断
	MY_NVIC_Init(1,3,TIM4_IRQn,1);
	TIM4->PSC = 0x0;//预分频器
	TIM4->ARR = ENCODER_TIM_PERIOD;//设定计数器自动重装值 
	TIM4->CR1 &=~(3<<8);// 选择时钟分频：不分频
	TIM4->CR1 &=~(3<<5);// 选择计数模式:边沿对齐模式
		
	TIM4->CCMR1 |= 1<<0; //CC1S='01' IC1FP1映射到TI1
	TIM4->CCMR1 |= 1<<8; //CC2S='01' IC2FP2映射到TI2
	TIM4->CCER &= ~(1<<1);	 //CC1P='0'	 IC1FP1不反相，IC1FP1=TI1
	TIM4->CCER &= ~(1<<5);	 //CC2P='0'	 IC2FP2不反相，IC2FP2=TI2
//	TIM4->CCMR1 |= 3<<4; //	IC1F='1000' 输入捕获1滤波器
	TIM4->SMCR |= 3<<0;	 //SMS='011' 所有的输入均在上升沿和下降沿有效
	TIM4->CR1 |= 0x01;    //CEN=1，使能定时器
}
/**************************************************************************
函数功能：把TIM5初始化为编码器接口模式
入口参数：无
返回  值：无
**************************************************************************/
void Encoder_Init_TIM5(void)
{
	RCC->APB1ENR|=1<<3;     //TIM5时钟使能
	RCC->APB2ENR|=1<<2;    //使能PORTA时钟
	GPIOA->CRL&=0XFFFFFF00;//PA0 PA1
	GPIOA->CRL|=0X00000044;//浮空输入
	TIM5->DIER|=1<<0;   //允许更新中断				
	TIM5->DIER|=1<<6;   //允许触发中断
	MY_NVIC_Init(1,3,TIM5_IRQn,1);
	TIM5->PSC = 0x0;//预分频器
	TIM5->ARR = ENCODER_TIM_PERIOD;//设定计数器自动重装值 
	TIM5->CR1 &=~(3<<8);// 选择时钟分频：不分频
	TIM5->CR1 &=~(3<<5);// 选择计数模式:边沿对齐模式
		
	TIM5->CCMR1 |= 1<<0; //CC1S='01' IC1FP1映射到TI1
	TIM5->CCMR1 |= 1<<8; //CC2S='01' IC2FP2映射到TI2
	TIM5->CCER &= ~(1<<1);	 //CC1P='0'	 IC1FP1不反相，IC1FP1=TI1
	TIM5->CCER &= ~(1<<5);	 //CC2P='0'	 IC2FP2不反相，IC2FP2=TI2
//	TIM2->CCMR1 |= 3<<4; //	IC1F='1000' 输入捕获1滤波器
	TIM5->SMCR |= 3<<0;	 //SMS='011' 所有的输入均在上升沿和下降沿有效
	TIM5->CR1 |= 0x01;    //CEN=1，使能定时器
}
/**************************************************************************
函数功能：单位时间读取编码器计数
入口参数：定时器
返回  值：速度值
**************************************************************************/
int Read_Encoder(u8 TIMX)
{
	int Encoder_TIM;    
	switch(TIMX)
	{
		case 2:
		{
//			if(TIM2 -> CNT > 32768)	TIM2 -> CNT = 65536 - TIM2 -> CNT;
			Encoder_TIM = (short)TIM2 -> CNT;
			TIM2 -> CNT=0; 
		}
		break;
		
		case 3:
		{
//			if(TIM3 -> CNT > 32768)	TIM3 -> CNT = 65536 - TIM3 -> CNT;
			Encoder_TIM = (short)TIM3 -> CNT;
			TIM3 -> CNT=0; 
		}
		break;
		case 4:
		{
//			if(TIM4 -> CNT > 32768)	TIM4 -> CNT = 65536-TIM4 -> CNT;
			Encoder_TIM = (short)TIM4 -> CNT;
			TIM4 -> CNT=0; 
		}
		break;
		case 5:
		{
//			if(TIM5 -> CNT > 32768)	TIM5 -> CNT = 65536-TIM5 -> CNT;
			Encoder_TIM= (short)TIM5 -> CNT;
			TIM5 -> CNT=0; 
		}
		break;
		default: Encoder_TIM=0;
	}
	return Encoder_TIM;
}
/**************************************************************************
函数功能：TIM2中断服务函数
入口参数：无
返回  值：无
**************************************************************************/
void TIM2_IRQHandler(void)
{ 		    		  			    
	if(TIM2->SR&0X0001)//溢出中断
	{    				   				     	    	
	}				   
	TIM2->SR&=~(1<<0);//清除中断标志位 	    
}

/**************************************************************************
函数功能：TIM3中断服务函数
入口参数：无
返回  值：无
**************************************************************************/
void TIM3_IRQHandler(void)
{ 		    		  			    
	if(TIM3->SR&0X0001)//溢出中断
	{    				   				     	    	
	}				   
	TIM3->SR&=~(1<<0);//清除中断标志位 	    
}
/**************************************************************************
函数功能：TIM4中断服务函数
入口参数：无
返回  值：无
**************************************************************************/
void TIM4_IRQHandler(void)
{ 		    		  			    
	if(TIM4->SR&0X0001)//溢出中断
	{    				   				     	    	
	}				   
	TIM4->SR&=~(1<<0);//清除中断标志位 	    
}

/**************************************************************************
函数功能：TIM4中断服务函数
入口参数：无
返回  值：无
**************************************************************************/
void TIM5_IRQHandler(void)
{ 		    		  			    
	if(TIM5->SR&0X0001)//溢出中断
	{    				   				     	    	
	}				   
	TIM5->SR&=~(1<<0);//清除中断标志位 	    
}
