immersive-arts/Blimpy/robots/wheely/firmware/motor_controller/Moebius_stm32f103rct6_1.0.4/HardWare/MOTOR/motor.c

#include "motor.h"

/**************************************************************************
作者：墨比斯科技
我的淘宝小店：https://moebius.taobao.com/
**************************************************************************/

void MiniBalance_Motor_Init(void)
{
	GPIO_InitTypeDef GPIO_InitStructure;
	RCC_APB2PeriphClockCmd(RCC_APB2Periph_GPIOA, ENABLE);
	RCC_APB2PeriphClockCmd(RCC_APB2Periph_GPIOB, ENABLE);
	RCC_APB2PeriphClockCmd(RCC_APB2Periph_GPIOC, ENABLE);	
	RCC_APB2PeriphClockCmd(RCC_APB2Periph_GPIOD, ENABLE);
	RCC_APB2PeriphClockCmd(RCC_APB2Periph_AFIO, ENABLE);
	
	GPIO_PinRemapConfig(GPIO_Remap_SWJ_JTAGDisable, ENABLE); 				//关闭JTAG调试接口
	
	GPIO_InitStructure.GPIO_Mode = GPIO_Mode_IPU;				//上拉输入
	GPIO_InitStructure.GPIO_Pin = GPIO_Pin_12;
	GPIO_Init(GPIOA, &GPIO_InitStructure);

	GPIO_InitStructure.GPIO_Mode = GPIO_Mode_Out_PP;			//推挽输出
	GPIO_InitStructure.GPIO_Speed = GPIO_Speed_50MHz;			//50M 

	GPIO_InitStructure.GPIO_Pin = GPIO_Pin_0 | GPIO_Pin_1 | GPIO_Pin_4 | GPIO_Pin_5;
	GPIO_Init(GPIOB, &GPIO_InitStructure);
	
	GPIO_InitStructure.GPIO_Pin = GPIO_Pin_4 | GPIO_Pin_5 | GPIO_Pin_12;
	GPIO_Init(GPIOC, &GPIO_InitStructure);

	GPIO_InitStructure.GPIO_Pin = GPIO_Pin_2;					//端口配置
	GPIO_Init(GPIOD, &GPIO_InitStructure);						//根据设定参数初始化GPIO

	INA1=0;INB1=0;INC1=0;IND1=0;
	INA2=0;INB2=0;INC2=0;IND2=0;
	
	Set_MotorPWMA(0);
	Set_MotorPWMB(0);
	Set_MotorPWMC(0);
	Set_MotorPWMD(0);
}

void MiniBalance_PWM_Init(u16 arr,u16 psc)
{
	MiniBalance_Motor_Init();  //初始化电机控制所需IO
	
	RCC_APB2PeriphClockCmd(RCC_APB2Periph_TIM8, ENABLE);
	RCC_APB2PeriphClockCmd(RCC_APB2Periph_GPIOC, ENABLE);	
	
	RCC->APB2ENR|=1<<13;       //使能TIM8时钟    
	RCC->APB2ENR|=1<<4;        //PORTC时钟使能     
	GPIOC->CRH&=0XFFFFFF00;    //PORTC8复用输出
	GPIOC->CRH|=0X000000BB;    //PORTC8复用输出
	
	GPIOC->CRL&=0X00FFFFFF;    //PORTC6 7复用输出
	GPIOC->CRL|=0XBB000000;    //PORTC6 7复用输出
	TIM8->ARR=arr;             //设定计数器自动重装值 
	TIM8->PSC=psc;             //预分频器不分频
	TIM8->CCMR1|=6<<4;         //CH1 PWM1模式	
	TIM8->CCMR1|=6<<12;        //CH2 PWM1模式	
	TIM8->CCMR2|=6<<4;         //CH3 PWM1模式	
	TIM8->CCMR2|=6<<12;        //CH4 PWM1模式	
	
	TIM8->CCMR1|=1<<3;         //CH1预装载使能	  
	TIM8->CCMR1|=1<<11;        //CH2预装载使能	 
	TIM8->CCMR2|=1<<3;         //CH3预装载使能	  
	TIM8->CCMR2|=1<<11;        //CH4预装载使能	  
//	
	TIM8->CCER|=1<<0;         //CH1输出使能	
	TIM8->CCER|=1<<4;         //CH2输出使能	   
	TIM8->CCER|=1<<8;         //CH3输出使能	 
	TIM8->CCER|=1<<12;        //CH4输出使能
	TIM8->CCR1=0;
	TIM8->CCR2=0;
	TIM8->CCR3=0;
	TIM8->CCR4=0;
	TIM8->BDTR |= 1<<15;       //TIM8必须要这句话才能输出PWM
	TIM8->CR1=0x8000;          //ARPE使能 
	TIM8->CR1|=0x01;          //使能定时器1 
} 
