immersive-arts/Blimpy/robots/wheely/firmware/motor_controller/Moebius_stm32f103rct6_1.0.4/HardWare/ENCODER/encoder.h

#ifndef __ENCODER_H
#define __ENCODER_H
#include <sys.h>	 
  /**************************************************************************
作者：墨比斯科技
我的淘宝小店：https://moebius.taobao.com/
**************************************************************************/
#define ENCODER_TIM_PERIOD (u16)(65535)   //不可大于65535 因为F103的定时器是16位的。
void Encoder_Init_TIM2(void);
void Encoder_Init_TIM3(void);
void Encoder_Init_TIM4(void);
void Encoder_Init_TIM5(void);
int Read_Encoder(u8 TIMX);

void TIM2_IRQHandler(void);
void TIM3_IRQHandler(void);
void TIM4_IRQHandler(void);
void TIM5_IRQHandler(void);
#endif
