immersive-arts/Blimpy/robots/wheely/firmware/nuttx/apps/wheely/hello/hello_main2.c

/****************************************************************************
 * apps/examples/hello/hello_main.c
 *
 * Licensed to the Apache Software Foundation (ASF) under one or more
 * contributor license agreements.  See the NOTICE file distributed with
 * this work for additional information regarding copyright ownership.  The
 * ASF licenses this file to you under the Apache License, Version 2.0 (the
 * "License"); you may not use this file except in compliance with the
 * License.  You may obtain a copy of the License at
 *
 *   http://www.apache.org/licenses/LICENSE-2.0
 *
 * Unless required by applicable law or agreed to in writing, software
 * distributed under the License is distributed on an "AS IS" BASIS, WITHOUT
 * WARRANTIES OR CONDITIONS OF ANY KIND, either express or implied.  See the
 * License for the specific language governing permissions and limitations
 * under the License.
 *
 ****************************************************************************/

/****************************************************************************
 * Included Files
 ****************************************************************************/

#include <nuttx/config.h>

#include <arpa/inet.h>
#include <sys/select.h>
#include <fcntl.h>
#include <signal.h>
#include <stdbool.h>
#include <stdio.h>
#include <unistd.h>

#include "../../wheely/hello/tinyosc.h"

/****************************************************************************
 * Public Functions
 ****************************************************************************/

static volatile bool keepRunning = true;

/****************************************************************************
 * hello_main
 ****************************************************************************/

int main(int argc, FAR char *argv[])
{
  printf("Hello, World MAXI1M!!\n");

  char buffer[2048]; // declare a 2Kb buffer to read packet data into

  printf("Starting write tests:\n");
  int len = 0;
  char blob[8] = {0x01, 0x23, 0x45, 0x67, 0x89, 0xAB, 0xCD, 0xEF};
  len = tosc_writeMessage(buffer, sizeof(buffer), "/address", "fsibTFNI",
      1.0f, "hello world", -1, sizeof(blob), blob);
  tosc_printOscBuffer(buffer, len);
  printf("done.\n");

  // open a socket to listen for datagrams (i.e. UDP packets) on port 9000
  const int fd = (AF_INET, SOCK_DGRAM, 0);
  fcntl(fd, F_SETFL, O_NONBLOCK); // set the socket to non-blocking
  struct sockaddr_in sin;
  sin.sin_family = AF_INET;
  sin.sin_port = htons(9000);
  sin.sin_addr.s_addr = INADDR_ANY;
  bind(fd, (struct sockaddr *) &sin, sizeof(struct sockaddr_in));
  printf("tinyosc is now listening on port 9000.\n");
  printf("Press Ctrl+C to stop.\n");

  while (keepRunning) {
    fd_set readSet;
    FD_ZERO(&readSet);
    FD_SET(fd, &readSet);
    struct timeval timeout = {1, 0}; // select times out after 1 second
    if (select(fd+1, &readSet, NULL, NULL, &timeout) > 0) {
    	printf("Timeout\n");
      struct sockaddr sa; // can be safely cast to sockaddr_in
      socklen_t sa_len = sizeof(struct sockaddr_in);
      int len = 0;
      while ((len = (int) recvfrom(fd, buffer, sizeof(buffer), 0, &sa, &sa_len)) > 0) {
        if (tosc_isBundle(buffer)) {
          tosc_bundle bundle;
          tosc_parseBundle(&bundle, buffer, len);
          const uint64_t timetag = tosc_getTimetag(&bundle);
          tosc_message osc;
          while (tosc_getNextMessage(&bundle, &osc)) {
            tosc_printMessage(&osc);
          }
        } else {
          tosc_message osc;
          tosc_parseMessage(&osc, buffer, len);
          tosc_printMessage(&osc);
        }
      }
    }
  }

  // close the UDP socket
  close(fd);

  return 0;
}
