immersive-arts/Blimpy/robots/wheely/firmware/nuttx/apps/wheely/hello/perf_counter.c

/****************************************************************************
 *
 *   Copyright (C) 2012 PX4 Development Team. All rights reserved.
 *
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
 * 1. Redistributions of source code must retain the above copyright
 *    notice, this list of conditions and the following disclaimer.
 * 2. Redistributions in binary form must reproduce the above copyright
 *    notice, this list of conditions and the following disclaimer in
 *    the documentation and/or other materials provided with the
 *    distribution.
 * 3. Neither the name PX4 nor the names of its contributors may be
 *    used to endorse or promote products derived from this software
 *    without specific prior written permission.
 *
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
 ****************************************************************************/

/**
 * @file perf_counter.c
 *
 * @brief Performance measuring tools.
 */

#include "perf_counter.h"

#include <stdlib.h>
#include <stdio.h>
#include <math.h>

#include <nuttx/clock.h>

/**
 * Header common to all counters.
 */
struct perf_ctr_header
{
	sq_entry_t link; /**< list linkage */
	enum perf_counter_type type; /**< counter type */
	const char *name; /**< counter name */
};

/**
 * PC_EVENT counter.
 */
struct perf_ctr_count
{
	struct perf_ctr_header hdr;
	uint64_t event_count;
};

/**
 * PC_ELAPSED counter.
 */
struct perf_ctr_elapsed
{
	struct perf_ctr_header hdr;
	uint64_t event_count;
	uint64_t time_start;
	uint64_t time_total;
	uint64_t time_least;
	uint64_t time_most;
};

/**
 * PC_INTERVAL counter.
 */
struct perf_ctr_interval
{
	struct perf_ctr_header hdr;
	uint64_t event_count;
	uint64_t time_event;
	uint64_t time_first;
	uint64_t time_last;
	uint64_t time_least;
	uint64_t time_most;
	double recurive_avg;
	double recurive_var;

};

/**
 * List of all known counters.
 */
static sq_queue_t perf_counters;

perf_counter_t
perf_alloc (enum perf_counter_type type, const char *name)
{
	perf_counter_t ctr = NULL;

	switch (type)
		{
		case PC_COUNT:
			ctr = (perf_counter_t) calloc (sizeof(struct perf_ctr_count), 1);
			break;

		case PC_ELAPSED:
			ctr = (perf_counter_t) calloc (sizeof(struct perf_ctr_elapsed), 1);
			break;

		case PC_INTERVAL:
			ctr = (perf_counter_t) calloc (sizeof(struct perf_ctr_interval), 1);
			break;

		default:
			break;
		}

	if (ctr != NULL)
		{
			ctr->type = type;
			ctr->name = name;
			sq_addfirst (&ctr->link, &perf_counters);
		}

	return ctr;
}

void
perf_free (perf_counter_t handle)
{
	if (handle == NULL)
		return;

	sq_rem (&handle->link, &perf_counters);
	free (handle);
}

void
perf_count (perf_counter_t handle)
{
	if (handle == NULL)
		return;

	switch (handle->type)
		{
		case PC_COUNT:
			((struct perf_ctr_count *) handle)->event_count++;
			break;

		case PC_INTERVAL:
			{
				struct perf_ctr_interval *pci = (struct perf_ctr_interval *) handle;
				clock_t now = clock_systime_ticks();

				switch (pci->event_count)
					{
					case 0:
						pci->time_first = now;
						break;
					case 1:
						pci->time_least = now - pci->time_last;
						pci->time_most = now - pci->time_last;
						pci->recurive_avg = now - pci->time_last;
						pci->recurive_var = 0;
						break;
					default:
						{
							clock_t interval = now - pci->time_last;
							if (interval < pci->time_least)
								pci->time_least = interval;
							if (interval > pci->time_most)
								pci->time_most = interval;

							double k = (double) pci->event_count;
							pci->recurive_avg = (k - 1) / k * pci->recurive_avg
									+ 1 / k * interval;
							pci->recurive_var = (k - 1) / k * pci->recurive_var
									+ 1 / (k - 1) * ((double) interval - pci->recurive_avg)
											* ((double) interval - pci->recurive_avg);

							break;
						}
					}
				pci->time_last = now;
				pci->event_count++;
				break;
			}

		default:
			break;
		}
}

void
perf_begin (perf_counter_t handle)
{
	if (handle == NULL)
		return;

	switch (handle->type)
		{
		case PC_ELAPSED:
			((struct perf_ctr_elapsed *) handle)->time_start = clock_systime_ticks();
			break;

		default:
			break;
		}
}

void
perf_end (perf_counter_t handle)
{
	if (handle == NULL)
		return;

	switch (handle->type)
		{
		case PC_ELAPSED:
			{
				struct perf_ctr_elapsed *pce = (struct perf_ctr_elapsed *) handle;

				if (pce->time_start != 0)
					{
						clock_t elapsed = clock_systime_ticks() - pce->time_start;

						pce->event_count++;
						pce->time_total += elapsed;

						if ((pce->time_least > elapsed) || (pce->time_least == 0))
							pce->time_least = elapsed;

						if (pce->time_most < elapsed)
							pce->time_most = elapsed;

						pce->time_start = 0;
					}
			}
			break;

		default:
			break;
		}
}

void
perf_cancel (perf_counter_t handle)
{
	if (handle == NULL)
		return;

	switch (handle->type)
		{
		case PC_ELAPSED:
			{
				struct perf_ctr_elapsed *pce = (struct perf_ctr_elapsed *) handle;

				pce->time_start = 0;
			}
			break;

		default:
			break;
		}
}

void
perf_reset (perf_counter_t handle)
{
	if (handle == NULL)
		return;

	switch (handle->type)
		{
		case PC_COUNT:
			((struct perf_ctr_count *) handle)->event_count = 0;
			break;

		case PC_ELAPSED:
			{
				struct perf_ctr_elapsed *pce = (struct perf_ctr_elapsed *) handle;
				pce->event_count = 0;
				pce->time_start = 0;
				pce->time_total = 0;
				pce->time_least = 0;
				pce->time_most = 0;
				break;
			}

		case PC_INTERVAL:
			{
				struct perf_ctr_interval *pci = (struct perf_ctr_interval *) handle;
				pci->event_count = 0;
				pci->time_event = 0;
				pci->time_first = 0;
				pci->time_last = 0;
				pci->time_least = 0;
				pci->time_most = 0;
				break;
			}
		}
}

void
perf_print_counter (perf_counter_t handle)
{
	if (handle == NULL)
		return;

	switch (handle->type)
		{
		case PC_COUNT:
			printf ("%-50s: %9llu events\n", handle->name,
							((struct perf_ctr_count *) handle)->event_count);
			break;

		case PC_ELAPSED:
			{
				struct perf_ctr_elapsed *pce = (struct perf_ctr_elapsed *) handle;

				printf (
						"%-50s: %9llu events, avg %9llu, min %9llu, max %9llu, elapsed %10llu [us]\n",
						handle->name, pce->event_count, pce->time_total / pce->event_count,
						pce->time_least, pce->time_most, pce->time_total);
				break;
			}

		case PC_INTERVAL:
			{
				struct perf_ctr_interval *pci = (struct perf_ctr_interval *) handle;

				printf (
						"%-50s: %9llu events, avg %9llu, min %9llu, max %9llu, variance %9llu [us]\n",
						handle->name, pci->event_count, (long long) pci->recurive_avg,
						pci->time_least, pci->time_most,
						(long long) sqrt (pci->recurive_var));
				break;
			}

		default:
			break;
		}
}

uint64_t
perf_event_count (perf_counter_t handle)
{
	if (handle == NULL)
		return 0;

	switch (handle->type)
		{
		case PC_COUNT:
			return ((struct perf_ctr_count *) handle)->event_count;

		case PC_ELAPSED:
			{
				struct perf_ctr_elapsed *pce = (struct perf_ctr_elapsed *) handle;
				return pce->event_count;
			}

		case PC_INTERVAL:
			{
				struct perf_ctr_interval *pci = (struct perf_ctr_interval *) handle;
				return pci->event_count;
			}

		default:
			break;
		}
	return 0;
}

void
perf_print_all (void)
{
	perf_counter_t handle = (perf_counter_t) sq_peek(&perf_counters);

	while (handle != NULL)
		{
			perf_print_counter (handle);
			handle = (perf_counter_t) sq_next(&handle->link);
		}
}

void
perf_reset_all (void)
{
	perf_counter_t handle = (perf_counter_t) sq_peek(&perf_counters);

	while (handle != NULL)
		{
			perf_reset (handle);
			handle = (perf_counter_t) sq_next(&handle->link);
		}
}
