immersive-arts/Blimpy/robots/wheely/firmware/motor_controller/Moebius_stm32f103rct6_1.0.4/HardWare/EXTI/exti.c

#include "exti.h"
  /**************************************************************************
作者：墨比斯科技
我的淘宝小店：https://moebius.taobao.com/
**************************************************************************/

/**************************************************************************
函数功能：外部中断初始化
入口参数：无
返回  值：无 
**************************************************************************/
void EXTI15_Init(void)
{
	RCC->APB2ENR|=1<<3;    //使能PORTB时钟	   	 
	GPIOB->CRH&=0X0FFFFFFF; 
	GPIOB->CRH|=0X80000000;//PB15上拉输入
	GPIOB->ODR|=1<<15;      //PB15上拉	
	Ex_NVIC_Config(GPIO_B,15,FTIR);		//下降沿触发
	MY_NVIC_Init(2,1,EXTI15_10_IRQn,2);  	//抢占2，子优先级1，组2
}
