immersive-arts/Blimpy/robots/wheely/firmware/motor_controller/Moebius_stm32f103rct6_1.0.4/HardWare/EXTI/exti.h

#ifndef __EXTI_H
#define __EXIT_H	 
#include "sys.h"
  /**************************************************************************
作者：墨比斯科技
我的淘宝小店：https://moebius.taobao.com/
**************************************************************************/
#define INT PBin(15)   //PB5连接到MPU6050的中断引脚
void EXTI15_Init(void);	//外部中断初始化		 					    
#endif
