immersive-arts/Blimpy/(commit log)

2019-07-17 basic motor control
2019-07-18 added torque
2019-07-19 added mx axis as pitch
2019-07-19 added motion switch
2019-07-19 added prototype embedded model
2019-07-19 added wifi and battery indicators
2019-09-12 first pcb iteration
    [blimpy.brd, blimpy.csv, blimpy.sch]
2019-09-18 updated board design
    [blimpy.brd, blimpy.sch]
2019-09-18 added battery gauge
    [blimpy.brd, blimpy.sch]
2019-09-18 added address
    [blimpy.sch]
2019-09-19 removed todo
    [blimpy.sch]
2019-09-26 improved hbridge traces
    [blimpy.brd]
2019-09-26 added hbridge gnd traces
    [blimpy.brd]
2019-09-26 connected adjacent bridges
    [blimpy.brd]
2019-09-26 updated hbridge traces and prepared expander
    [blimpy.brd]
2019-09-26 use 0.2mm traces
    [blimpy.brd]
2019-09-26 wired io and caps
    [blimpy.brd]
2019-09-26 fixed io capacitors
    [blimpy.brd, blimpy.sch]
2019-09-26 finished hbridge io
    [blimpy.brd, blimpy.sch]
2019-09-26 move on place
    [blimpy.brd]
2019-09-26 small connections
    [blimpy.brd]
2019-09-26 updated labels
    [blimpy.brd]
2019-09-26 reworked main connectors
    [blimpy.brd]
2019-09-26 replaced usb micro with usb c connector
    [blimpy.brd, blimpy.sch]
2019-09-27 worked on power stuff
    [blimpy.brd]
2019-09-27 shrinked board
    [blimpy.brd]
2019-09-27 moved stuff into place
    [blimpy.brd]
2019-09-27 fixed size
    [blimpy.brd]
2019-09-27 fixed servo pins
    [blimpy.brd, blimpy.sch]
2019-09-27 moved in auxillary components
    [blimpy.brd]
2019-09-27 moved labels
    [blimpy.brd]
2019-09-27 small fix
    [blimpy.brd]
2019-09-27 connect imu
    [blimpy.brd]
2019-09-27 more traces
    [blimpy.brd]
2019-09-27 show all
    [blimpy.brd]
2019-09-27 small fixes
    [blimpy.brd]
2019-09-27 more fixes
    [blimpy.brd]
2019-09-27 added battery traces
    [blimpy.brd]
2019-09-27 updated vias
    [blimpy.brd]
2019-09-27 more power traces
    [blimpy.brd]
2019-09-27 improved power routing
    [blimpy.brd]
2019-09-27 hide some layers
    [blimpy.brd]
2019-09-27 connected all components
    [blimpy.brd, blimpy.sch]
2019-09-27 more connections
    [blimpy.brd]
2019-09-27 finished all traces
    [blimpy.brd, blimpy.sch]
2019-09-28 added ground plane and fixed all errors
    [blimpy.brd]
2019-09-28 changed colors
    [blimpy.brd]
2019-09-28 moved esp
    [blimpy.brd]
2019-09-28 added text
    [blimpy.brd]
2019-09-28 added esp32 pogo pins
    [blimpy.sch]
2019-09-28 updated todo
    [blimpy.sch]
2019-09-29 routed pogo pins
    [blimpy.brd]
2019-09-29 moved docs
    [blimpy.brd]
2019-09-29 bigger ground pads on h bridges
    [blimpy.brd]
2019-09-29 optimized main battery connections
    [blimpy.brd]
2019-09-29 moved led
    [blimpy.brd]
2019-09-29 rerouted io1-rst
    [blimpy.brd]
2019-09-29 reduced space
    [blimpy.brd]
2019-09-29 made more space
    [blimpy.brd]
2019-09-29 moved led to middle
    [blimpy.brd]
2019-09-29 updated bom
    [blimpy.csv]
2019-09-29 added more pogo pins
    [blimpy.brd, blimpy.sch]
2019-09-29 switched back to micro usb connector and moved led
    [blimpy.brd, blimpy.csv, blimpy.sch]
2019-09-29 added prices
    [blimpy.csv]
2019-09-30 removed obsolete resistors
    [blimpy.csv]
2019-09-30 updated docs
    [blimpy.brd, blimpy.sch]
2019-09-30 fixed typo
    [blimpy.brd, blimpy.sch]
2019-10-07 changed schotky diode to BAT20J
    [blimpy.brd, blimpy.csv, blimpy.sch]
2019-10-07 updated cree led part number
    [blimpy.csv]
2019-10-07 updated part numbers
    [blimpy.csv]
2019-10-24 print more stuff
2019-10-24 prototype onboard model calculation
2019-11-18 new motor control
2019-11-20 added two motors to model
2019-11-20 use on-board model
2019-11-20 clamp model result
2019-11-20 constrain before printing
2019-11-21 added min duty and print fault
2019-11-25 added servo control
2019-11-25 new repo architecture
    [blimpy-1.0-A.brd, blimpy-1.0-A.csv, blimpy-1.0-A.sch, blimpy-1.0-B.brd, blimpy-1.0-B.csv, blimpy-1.0-B.sch]
2019-12-05 prototype manager api
2019-12-09 added max sparck patcher for testing flightpaths
    [IASpace_CalibModel.obj, Paths.blend]
2019-12-12 new speed data fo the drones
    [Paths.blend]
2019-12-17 choreography three paths
    [Paths.blend]
2019-12-17 updated apps/max and formware documentation
    [Paths.blend]
2019-12-17 documentation almost finshed. folder name change
    [blimpy-1.0-A.brd, blimpy-1.0-A.csv, blimpy-1.0-A.sch, blimpy-1.0-B.brd, blimpy-1.0-B.csv, blimpy-1.0-B.sch]
2019-12-17 fanmount print insctructions complete
2019-12-17 new path forms
    [Paths.blend]
2019-12-17 path updates
    [Paths.blend]
2020-06-28 Added PCB 2.0
    [blimpy-2.0.brd, blimpy-2.0.sch]
2020-06-29 Added LED connector
    [blimpy-2.0.brd, blimpy-2.0.sch]
2020-06-29 Cosmetic changes
    [blimpy-2.0.brd, blimpy-2.0.sch]
2020-06-30 Motor driver bug fix, added pull-up for btn input, cosmetic changes
    [blimpy-2.0.brd, blimpy-2.0.sch]
2020-07-06 Added jumper to disable charging when MC is running
    [blimpy-2.0.brd, blimpy-2.0.sch]
2020-08-24 single expander for rgb led
2020-08-24 updated battery
2020-08-24 added power button
2020-08-24 added auto power off
2020-08-24 added new motor control
2020-08-25 better power button
2020-08-25 even better power button
2020-08-25 enabled servos
2020-08-25 fixed motor
2020-08-25 added battery debugging
2020-08-25 added battery monitoring
2020-08-26 Added revised PCB
    [blimpy-2.1.brd, blimpy-2.1.sch]
2020-08-26 PCB 2.1 production
    [blimpy-2.1.brd, blimpy-2.1.sch]
2020-08-27 updated drone controller
    [Paths.blend]
2020-08-30 updated blimpy wireless controller app
2020-08-31 updated DroneController with new ossia node
    [Paths.blend]
2020-09-04 finished servos selection and motion api
2020-09-11 Added motors output to GUI
2020-09-11 fix motor data
2020-09-11 Added option to switch between blimps for plotting
2020-10-27 new max package added blender path app
    [Show.blend]
2020-11-03 rearranged max apps and package and adjusted readme docs to refer to the same naming convention.
    [IASpace_CalibModel.obj, Paths.blend]
2020-11-05 fixed smal bux with BlenderController and blender - file
    [Show.blend]
2021-01-06 updated show file to latest NodeOSC version 2.0.0
    [Show.blend]
2021-05-16 added new device control abstraction based on javascript
2021-05-31 changed parameters for wheely
2021-06-25 Restructured directories to accommodate different hardware platforms
    [blimpy-1.0-A.brd, blimpy-1.0-A.csv, blimpy-1.0-A.sch, blimpy-1.0-B.brd, blimpy-1.0-B.csv, blimpy-1.0-B.sch, blimpy-2.0.brd, blimpy-2.0.csv]
2021-06-25 Add wheely firmware
2021-06-25 Add PCBWay production files
    [PCBWay_BOM.xlsx]
2021-06-25 Add original motor controller firmware
2021-06-25 Changes to motor controller for cross configuration
2021-06-25 Add readme for wheely
2021-06-25 added wheely design files
    [wheely_mk2.blend]
2021-06-26 added more instructions on connecting motors and electronics
2021-06-26 fixed readme to name the motor controller consitently through the text
2021-08-25 Reduce heartbeat rate of manager to 10 Hz
2021-08-25 Change manager to accept different devices (blimps, wheels, ...)
2021-08-25 Update GUI to work with different device_base_topics
2021-09-01 fixes for maxpatch device controller
    [Simple.blend]
2021-09-01 Add 'unmanaged' state when device is removed from manager
2021-09-01 more max-abstraction fixes for device control
2021-09-12 added test patch for motor checks
    [Simple.blend]
2021-09-14 Add missing angular velocity control
2021-09-15 Upgrade GUI to display state feedback of devices
2021-09-16 bugfixes for max patches
    [Simple.blend]
2021-10-13 added motor attachement diagram
2021-10-28 Handle unkown device type
2021-10-28 Add unavailable state, and battery charge information to GUI
2021-11-01 Bugfix in onboard model computation
    [mod.c]
2021-12-06 Calculate reference velocity if not provided
2021-12-06 Remove body rates reference from 'move' command (doesn't make sense in current controller implementation)
2021-12-06 updated max app to mirror new API changes
    [Simple.blend]
2021-12-06 Remove roll, pitch, yaw sliders from GUI and clarify variable names
2021-12-06 fixed velocity calc
    [Simple.blend]
2021-12-16 added help for fan setup and configuration
    [fanSetup.blend]
2022-03-15 update readme for flashing board
2022-03-17 added new blender inflation simulation file
    [inflationSim.blend]
2022-03-25 new processing template and example app for remote control of device
2022-03-28 apply motor map on raw motor command
2022-03-28 Add save button to GUI
2023-03-17 Update wheely controller for new omniwheel platform
2023-09-18 update motor check patch
2023-11-15 added missing sub systems
    [main.c]
2023-11-15 added missing error checks
    [exp.c, mot.c]
2023-11-15 upgraded wheely firmware versions
2023-11-15 fixed SPI mode
2023-11-16 updated wheely project name
2023-11-16 Add battery topic to wheely (always 0.0)
2023-11-16 Add wheely nuttx firmware
    [armusbocd.cfg, atmel-same70-qmtech.cfg, atmel-same70-xplained.cfg, atmel-samv71-xult.cfg, config.txt, dk-tm4c129x.cfg, ek-tm4c1294xl.cfg, ek-tm4c129exl.cfg]
2023-12-28 added documentation for wheely mk03
    [wheely_mk2.blend, wheely_mk3.4.blend]
2024-02-14 update readme to include hint about pressing the button to flash
2024-09-25 changed wheely device controller parameter
